oseiler2/CO2Monitor/case/Panel dimensions.PNG

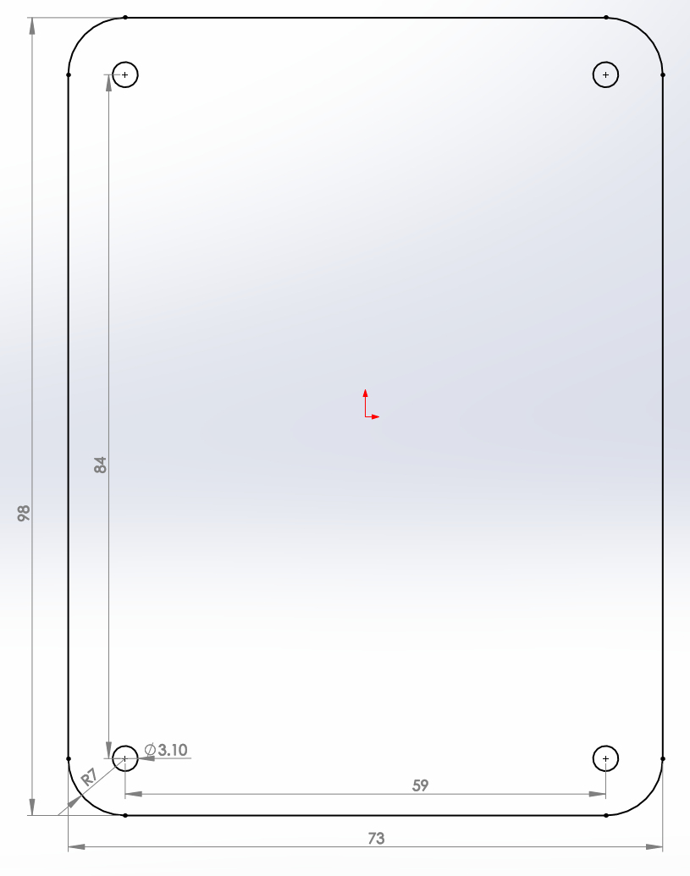
case/Panel dimensions.PNG
