oseiler2/CO2Monitor/case/Case v0.4_15mm_cable.STL

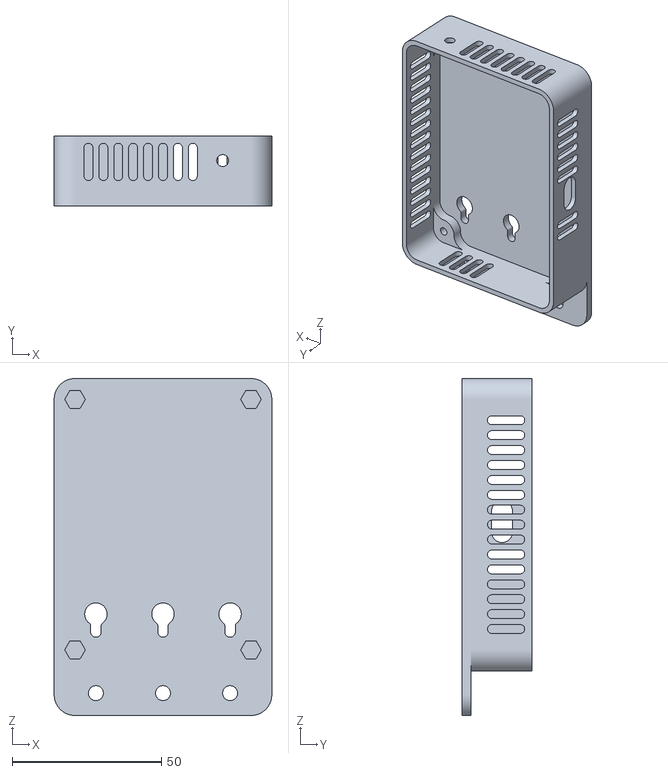
[picture p13: CAD file, 2022-06-09]
case/Case v0.4_15mm_cable.STL
73.0 x 23.6 x 113.0
