oseiler2/CO2Monitor/pcb/CO2 Monitor V0.5 SMD/3dmodels/SCD30--3DModel-STEP-56544.STEP

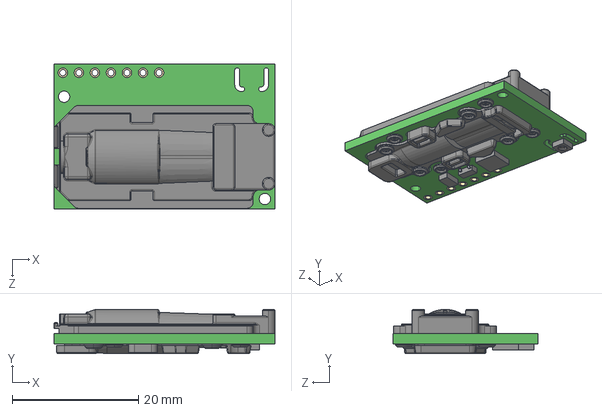
[picture p14: CAD file, 2022-06-16]
pcb/CO2 Monitor V0.5 SMD/3dmodels/SCD30--3DModel-STEP-56544.STEP
35.0 x 7.00 x 23.0 mm
