oseiler2/CO2Monitor/case/Case v0.4_15mmSPS30_USB.STL

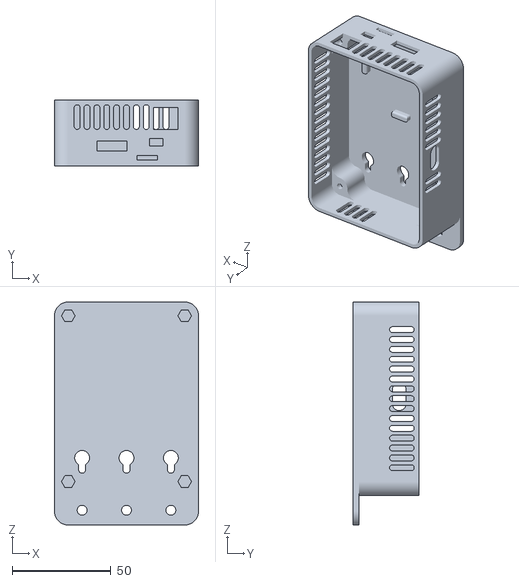
[picture p16: CAD file, 2022-06-09]
case/Case v0.4_15mmSPS30_USB.STL
73.0 x 33.6 x 113.0
