oseiler2/CO2Monitor/pcb/CO2 Monitor V0.5 through-hole/3dmodels/USB 2.0 Type B Connector Right Angle (Würth 61400416121).stp

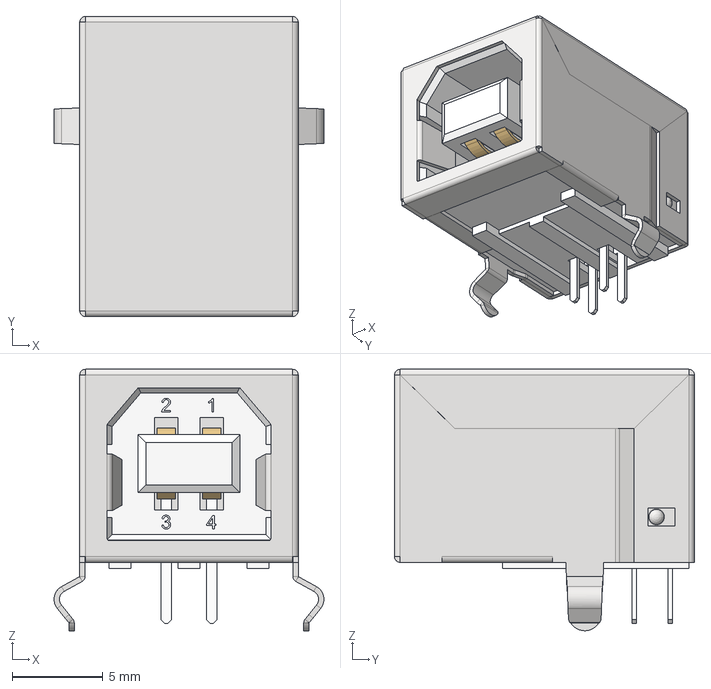
[picture p17: CAD file, 2022-06-16]
pcb/CO2 Monitor V0.5 through-hole/3dmodels/USB 2.0 Type B Connector Right Angle (Würth 61400416121).stp
14.8 x 16.5 x 14.4 mm
