oseiler2/CO2Monitor/pcb/CO2 Monitor V0.5 SMD/3dmodels/USB-B-SMD 1-1734346-1.step

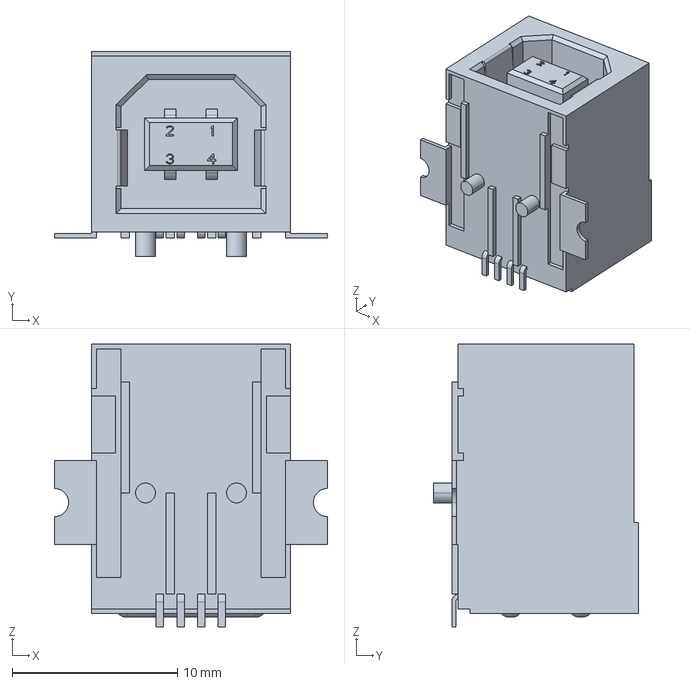
[picture p19: CAD file, 2022-06-16]
pcb/CO2 Monitor V0.5 SMD/3dmodels/USB-B-SMD 1-1734346-1.step
16.5 x 12.4 x 17.1 mm
