oseiler2/CO2Monitor/pcb/CO2 Monitor V0.5 SMD/3dmodels/BME680.step

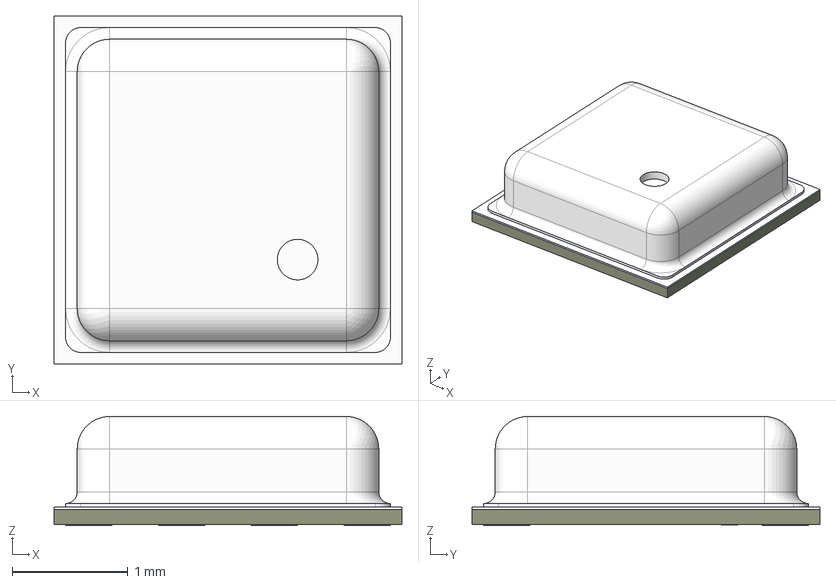
[picture p21: CAD file, 2022-06-16]
pcb/CO2 Monitor V0.5 SMD/3dmodels/BME680.step
3.00 x 3.00 x 0.94 mm
pads
pcb
lid
