oseiler2/CO2Monitor/pcb/CO2 Monitor V0.5 SMD/3dmodels/SCD40-D-R2--3DModel-STEP-369182.STEP

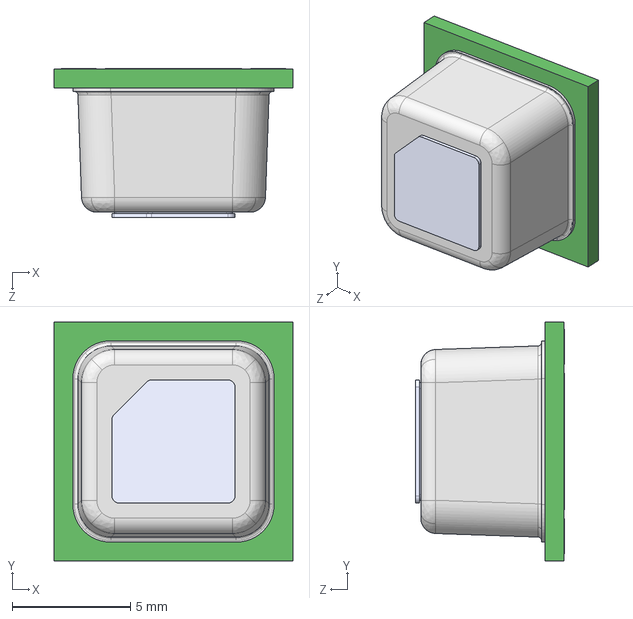
[picture p22: CAD file, 2022-06-16]
pcb/CO2 Monitor V0.5 SMD/3dmodels/SCD40-D-R2--3DModel-STEP-369182.STEP
10.1 x 10.1 x 6.31 mm
