oseiler2/CO2Monitor/pcb/CO2 Monitor V0.5 SMD/3dmodels/B5B-ZR_LF__SN_.step

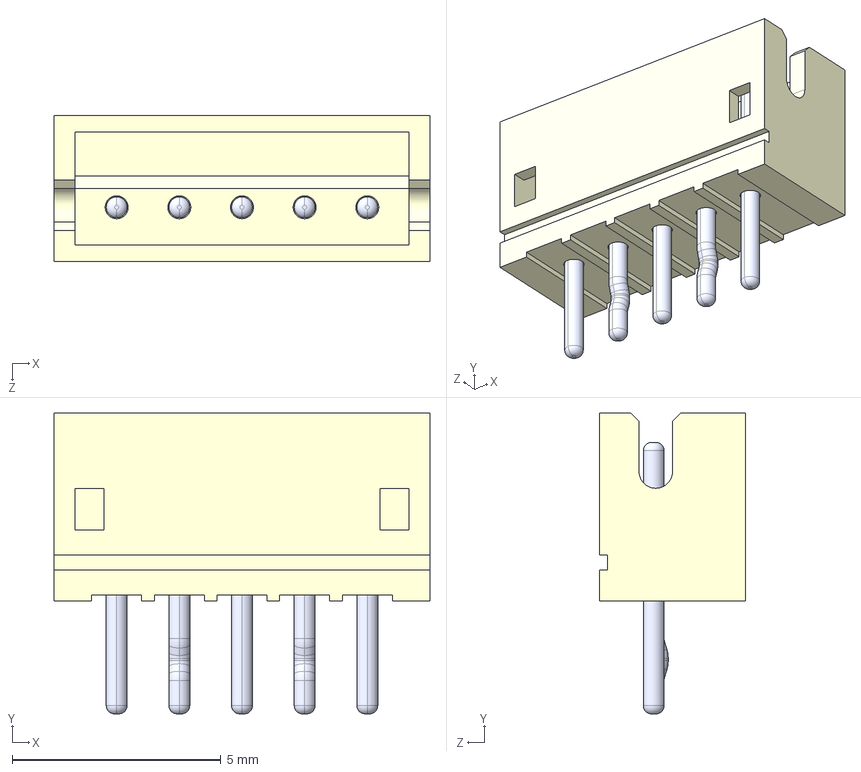
[picture p23: CAD file, 2022-06-16]
pcb/CO2 Monitor V0.5 SMD/3dmodels/B5B-ZR_LF__SN_.step
9.00 x 7.20 x 3.50 mm
