oseiler2/CO2Monitor/pcb/CO2 Monitor V0.5 through-hole/step-by-step.md

# CO2 monitor through-hole step by step assembly guide

This guide will take you through all necessary steps to assemble the through-hole version of the CO2 monitor if you ware building your own from a kit or parts that you have sourced yourself.

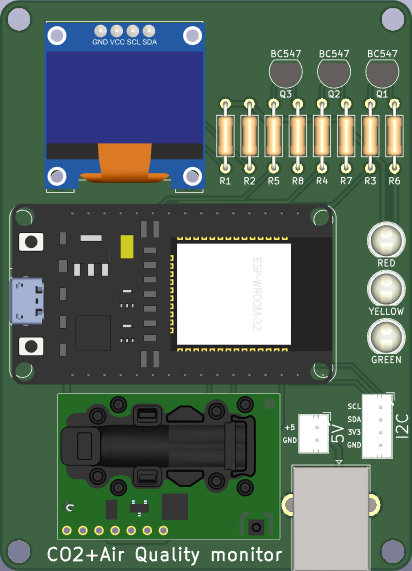
[picture p24: pcb/CO2 Monitor V0.5 through-hole/CO2Monitor-TH-V0.5.render.png]


## Preparations



Before you start make sure you have all [required parts](./bom.md) and tools ready. You'll need:

- soldering iron
- solder
- good ventilation and ideally a solder fume extractor
- side cutters
- safety glasses
- USB power
- micro USB cable
- 2mm hex (Allen) key
- (optional) multimeter

## PCB assembly

1. Start with soldering the resistors to the PCB. If you are unsure about the resistor values and don't have a multimeter handy use a [resistor colour code decoder](https://www.digikey.co.nz/en/resources/conversion-calculators/conversion-calculator-resistor-color-code) to confirm the correct value. Bend the resistors at ~10mm and put them through the PCB before soldering them in place. Cut the wires close to the PCB once soldered in place.

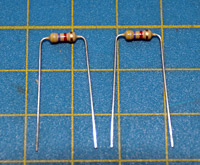
[picture p25: pcb/CO2 Monitor V0.5 through-hole/01-resistors.jpg]
   

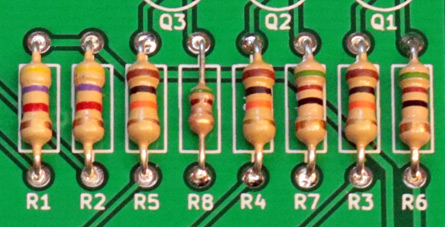
[picture p26: pcb/CO2 Monitor V0.5 through-hole/02-resistors.jpg]
   

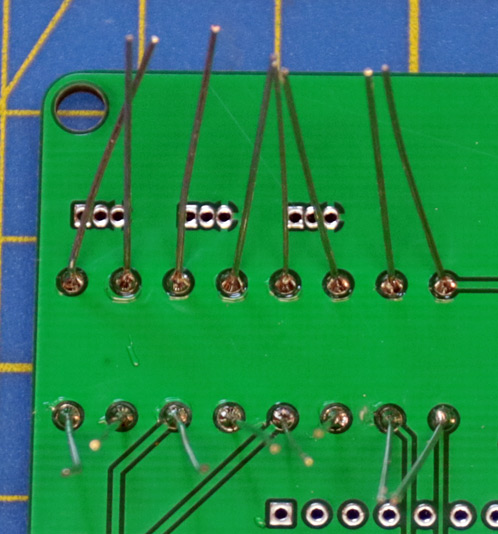
[picture p27: pcb/CO2 Monitor V0.5 through-hole/03-resistors.jpg]
   

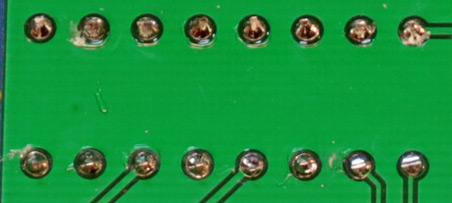
[picture p28: pcb/CO2 Monitor V0.5 through-hole/04-resistors.jpg]
   

2. Place the 3 BC547 transistors in place making sure the flat side of the package aligns with the shape of the silkscreen. You might have to bend the wires a little to make them fit. You don't need to push them all the way to the bottom, but make sure that the wires don't touch each other.

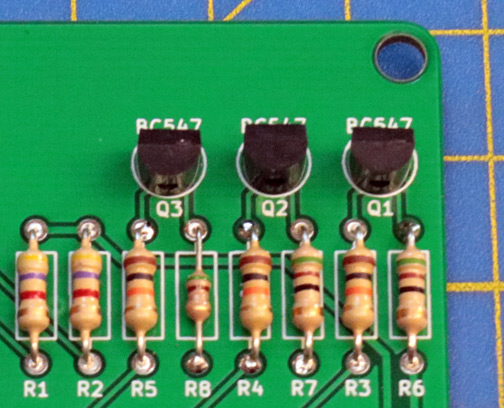
[picture p29: pcb/CO2 Monitor V0.5 through-hole/05-transistors.jpg]
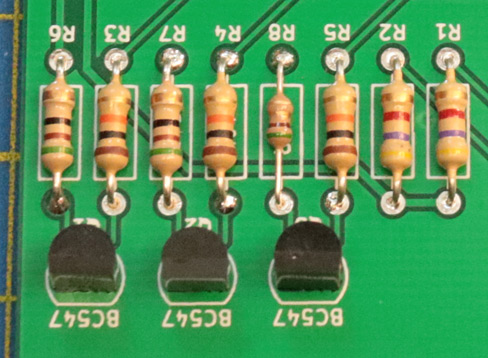
[picture p30: pcb/CO2 Monitor V0.5 through-hole/06-transistors.jpg]
    

3. The 3 LEDs must be installed in the correct orientation with the anode (+ side) facing the top of the PCB. The lead on the anode is a little longer. You can also check the correct orientation with a multimeter

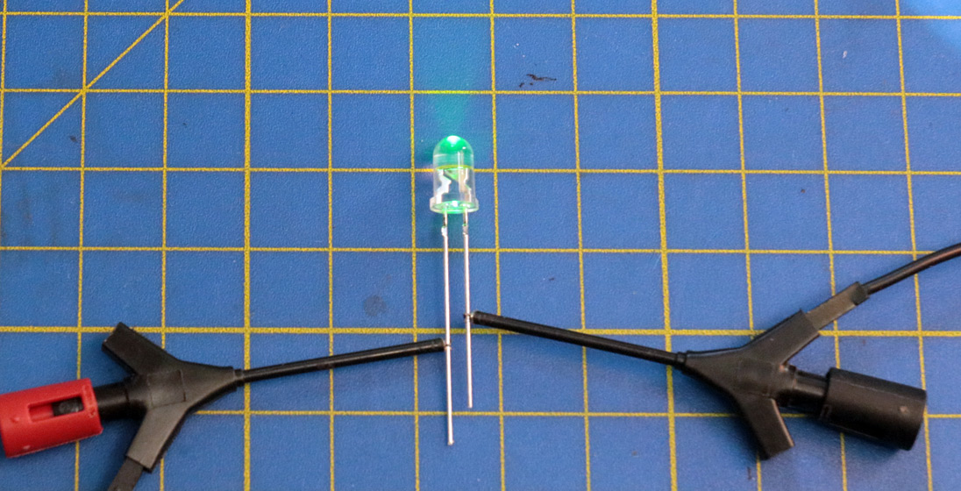
[picture p31: pcb/CO2 Monitor V0.5 through-hole/07-leds.jpg]
   

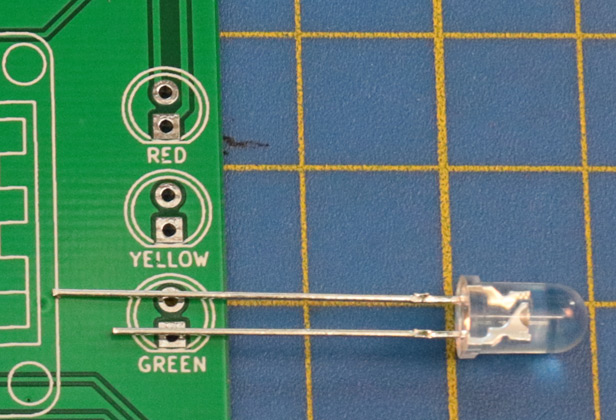
[picture p32: pcb/CO2 Monitor V0.5 through-hole/08-leds.jpg]
   

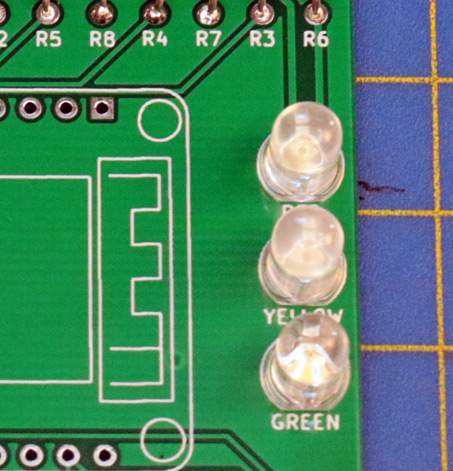
[picture p33: pcb/CO2 Monitor V0.5 through-hole/09-leds.jpg]
   

4. The ESP32 micro controller comes next. Make sure to install it in the right direction with the USB port facing left. It can be a little difficult to push in if the pins don't perfectly align. In that case start at one side and slowly move from pin to pin, carefully pushing each pin into position. Start soldering at one end and check that it is fully inserted after soldering the first pin before continuing with the reamining pins. When you're done soldering the pins will need to be shortened with a wire cutter for the PCB to properly fit into the case. When clipping the pins be careful since they are thicker than resistor wires and tend to fly away. Wear safety glasses and cover then pins with a cloth/rug when clipping them.

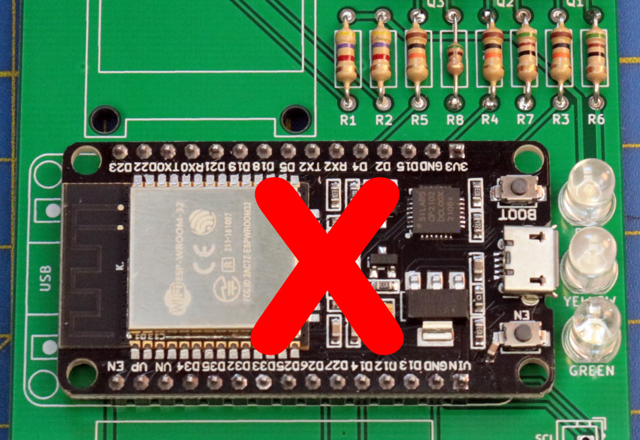
[picture p34: pcb/CO2 Monitor V0.5 through-hole/10-esp32.jpg]
   

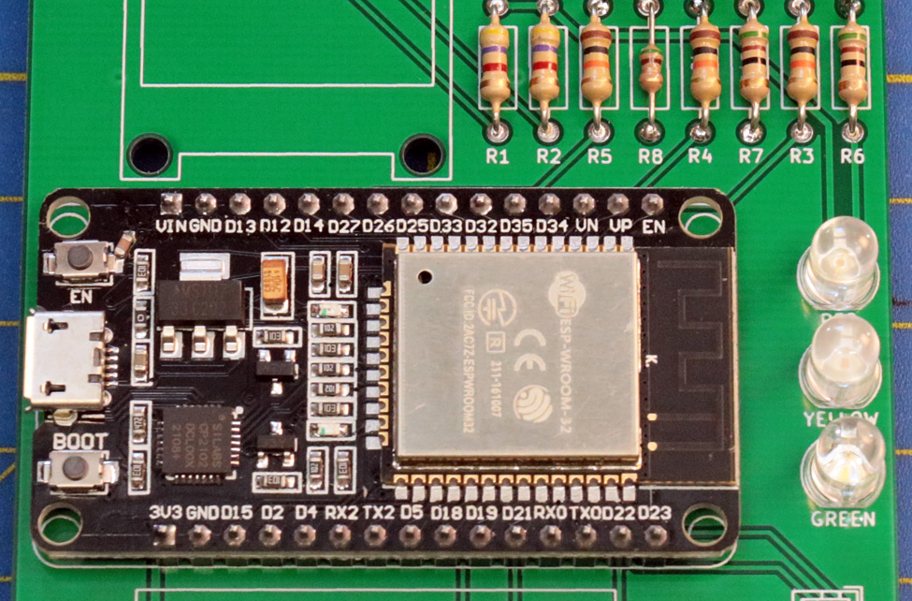
[picture p35: pcb/CO2 Monitor V0.5 through-hole/11-esp32.jpg]
   

5. Solder only one pin of the display before checking the correct alignment. It's easier to adjust while only one pin is connected. Then solder the remaining pins. Leave the protective film on the display for now.

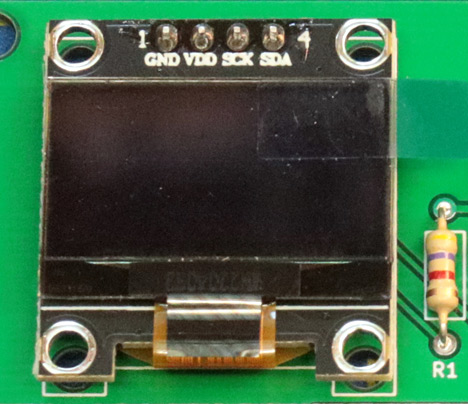
[picture p36: pcb/CO2 Monitor V0.5 through-hole/12-lcd.jpg]
   

6. If the SCD30 sensor comes without a pre-soldered pin header, solder a 7 pin header to the sensor first. If you have a prototyping bread board available use it to keep the pin header straight; otherwise carefully solder one pin only and adjust as needed before completing the remaining ones.

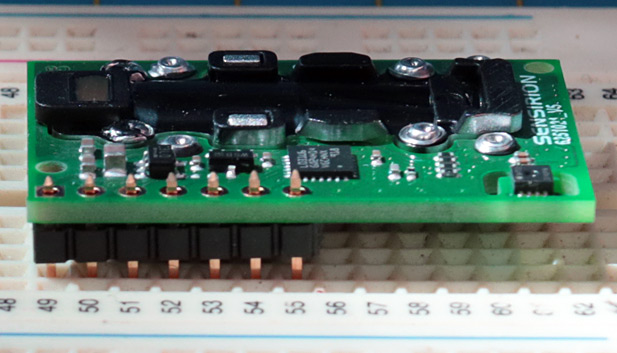
[picture p37: pcb/CO2 Monitor V0.5 through-hole/13-scd30.jpg]


Solder the SCD30 sensor to the main PCB while making sure it lies flat on the board. Don't push the pins in all the way.

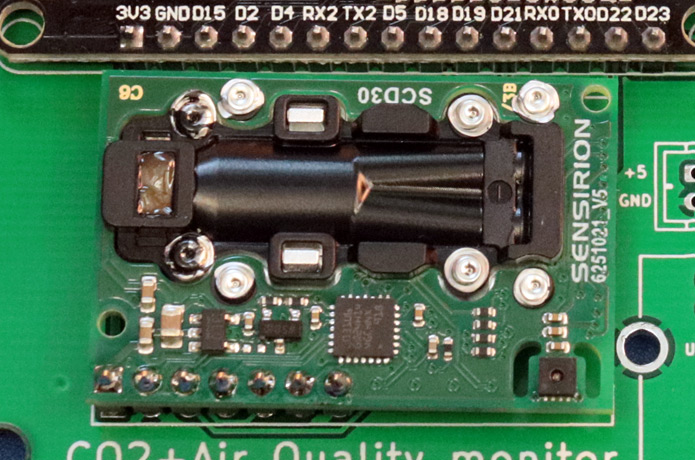
[picture p38: pcb/CO2 Monitor V0.5 through-hole/15-scd30.jpg]


7. (optional) Place and solder the JST headers for power and I2C and the USB-B power connector.

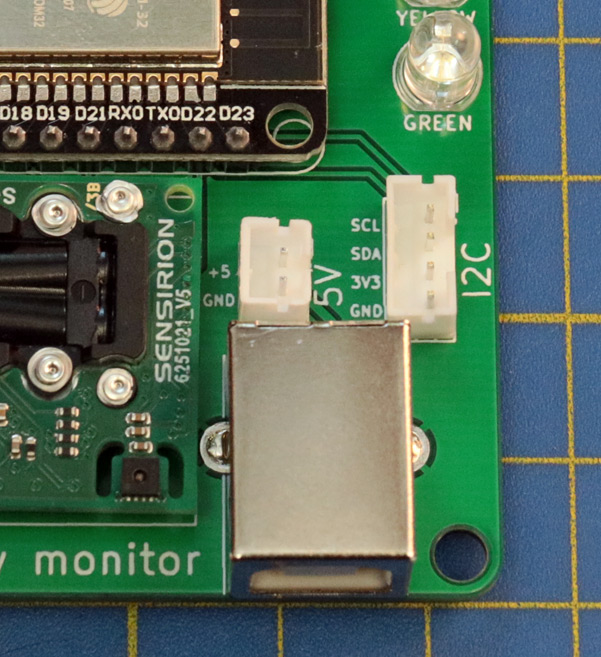
[picture p39: pcb/CO2 Monitor V0.5 through-hole/16-connectors.jpg]


8. (optional) Apply a small amount of liquid electrical tape over the 2 LEDs on the ESP32 to reduce their brightness.

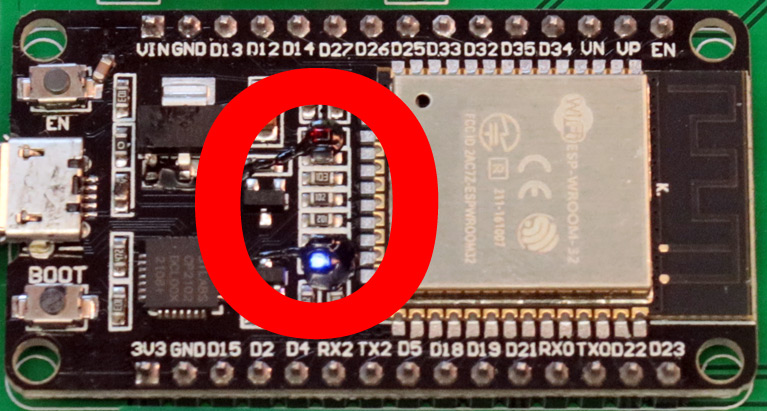
[picture p40: pcb/CO2 Monitor V0.5 through-hole/17-liquid-tape.jpg]


9. Before plugging the monitor in, have a good look at all components and make sure that all components are installed in the correct location and orientation, all solder joints are well done and not short circuited and everything looks right. Then plug a micro-USB cable into the ESP32 and flash the firmware.
   The monitor will start up and display the name of its WiFi access point in the first row on the display. After a short while it will also show a CO2 reading. Don't worry that the LEDs don't turn on quite yet as they'll need to be enabled in the configuration first.

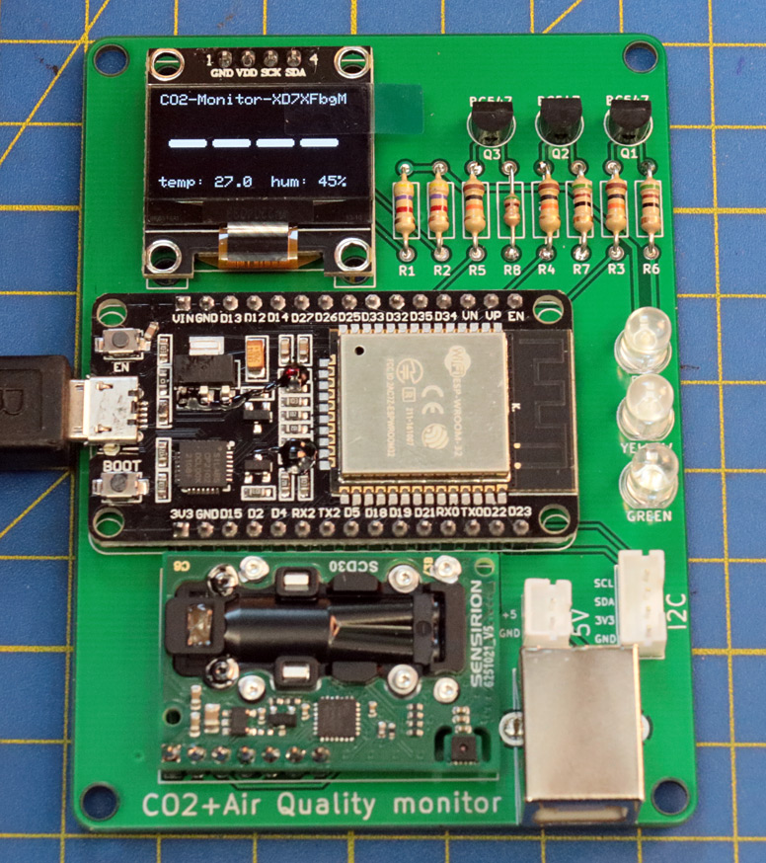
[picture p41: pcb/CO2 Monitor V0.5 through-hole/18-flash.jpg]


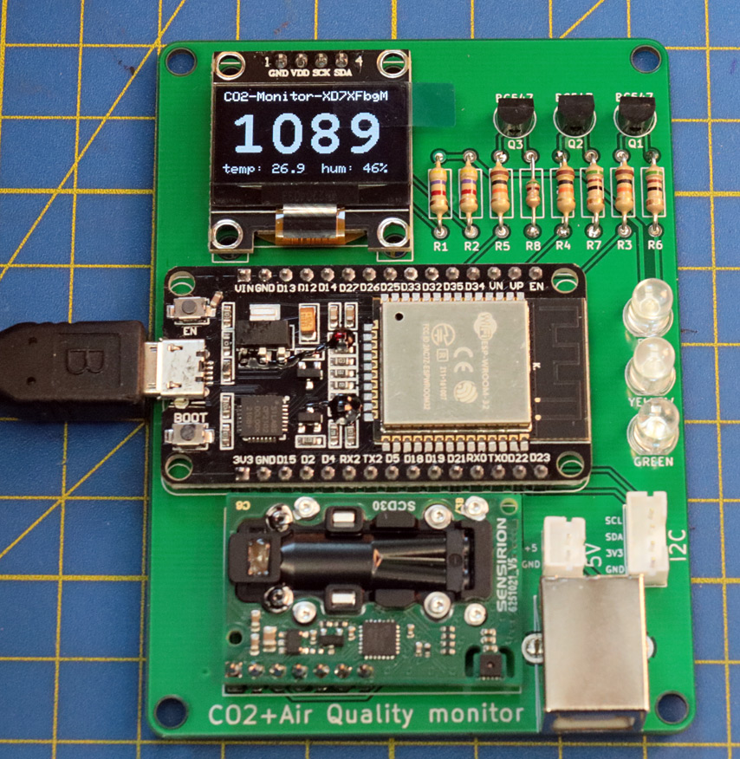
[picture p42: pcb/CO2 Monitor V0.5 through-hole/19-flash.jpg]


10. Connect to the monitor's Wifi access point and configure the Wifi and enable the LEDs by setting the following in the configuration:

```
  "greenLed": 27,
  "yellowLed": 26,
  "redLed": 25,
```

You'll then see the LEDs light up according to the CO2 reading. The electrical part of the assembly is complete.

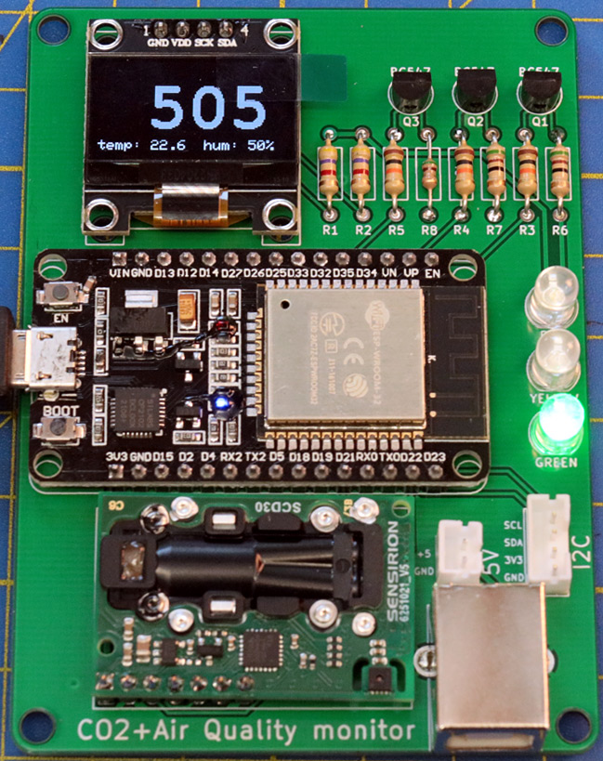
[picture p43: pcb/CO2 Monitor V0.5 through-hole/20-test.jpg]


11. There are 2 ways to install the monitor in the case. Placing it upside down on the front panel can be easier.
    Remove the protective film from the acrylic front panel and the LCD. Push the 4 screws through the front panel and place it on a flat surface with the screw heads facing down. Then push the stand offs over the screws before placing the PCB upside down over the screws.

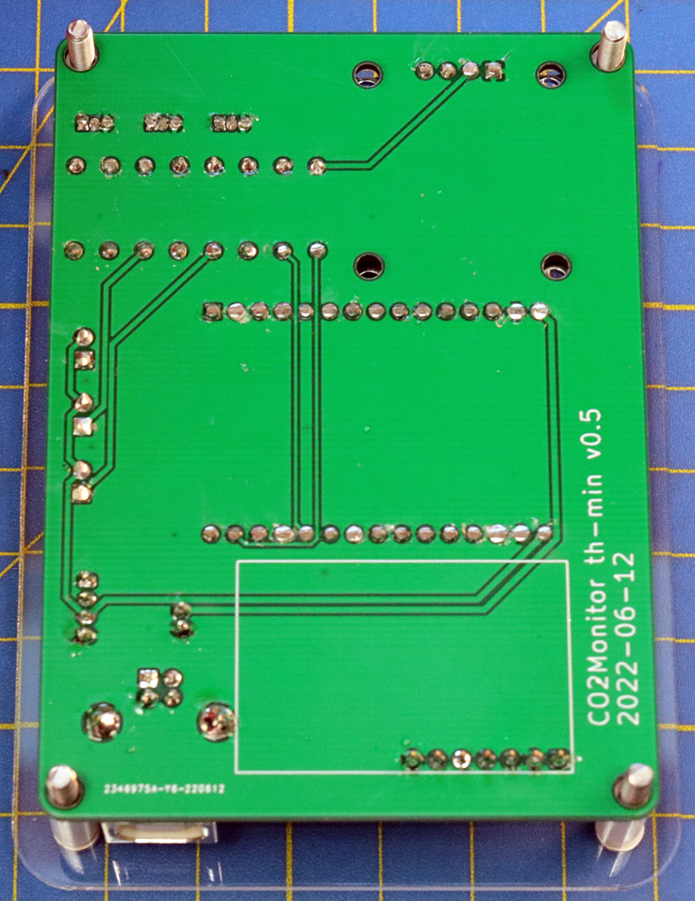
[picture p44: pcb/CO2 Monitor V0.5 through-hole/21-assembly.jpg]


Then place the case upside down over the screws, carefully pushing the screws through the holes. Place the hex nuts, carefully lift the case sideways and secure the screws with a hex (Allen) key without overtightening them. You can use a little bit of glue, electrical tape or similar to hold the hex nuts in place and stop them from falling out.

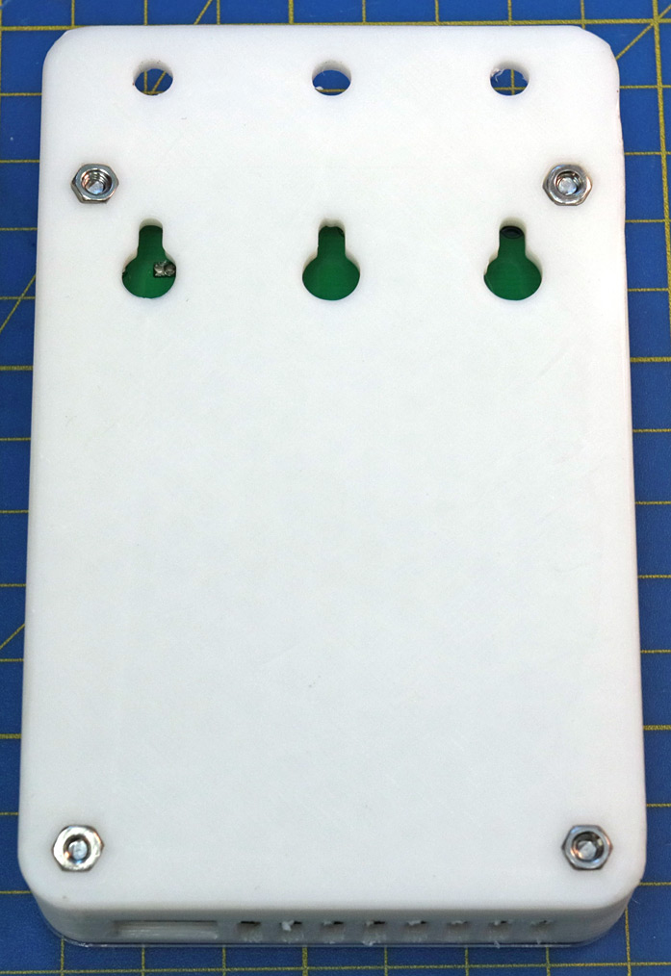
[picture p45: pcb/CO2 Monitor V0.5 through-hole/22-assembly.jpg]


12. Alternatively start with the case in the correct orientation and place the PCB into the case. You can insert the hex nuts first and secure them in place, or add them later, depending on what works best for you. Remove the protective film from the display. Slide the stand offs over a screw-driver or hex (Allen) key into position and carefully let them rest on the PCB before placing the front panel on top. The stand offs don't need to be perfectly aligned and the front panel can be moved sideways to some degree while inserting the screws through the panel and stand offs into the bottom holes of the case. Secure the screws with a hex (Allen) key without overtightening them.

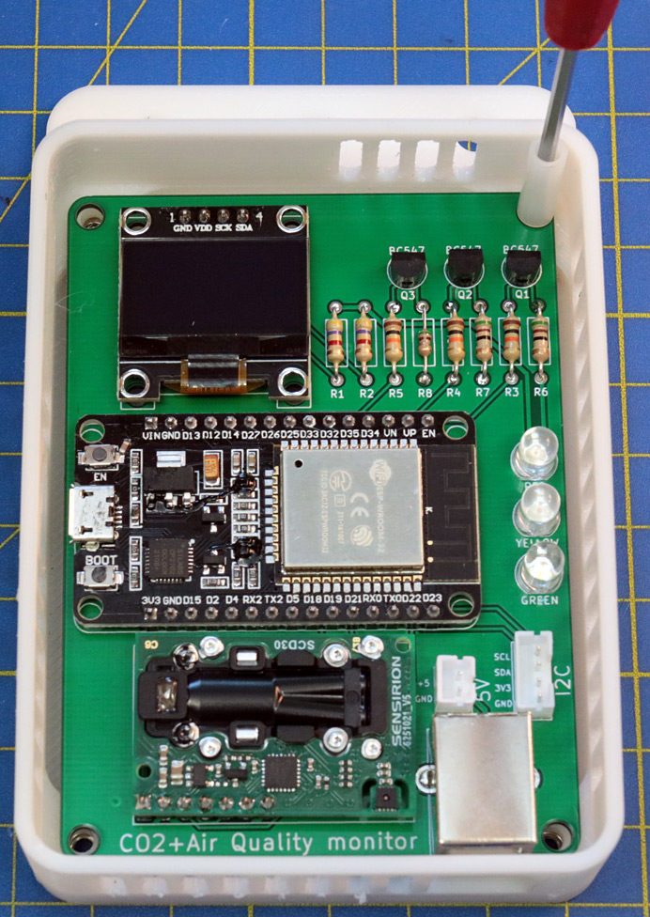
[picture p46: pcb/CO2 Monitor V0.5 through-hole/23-assembly.jpg]


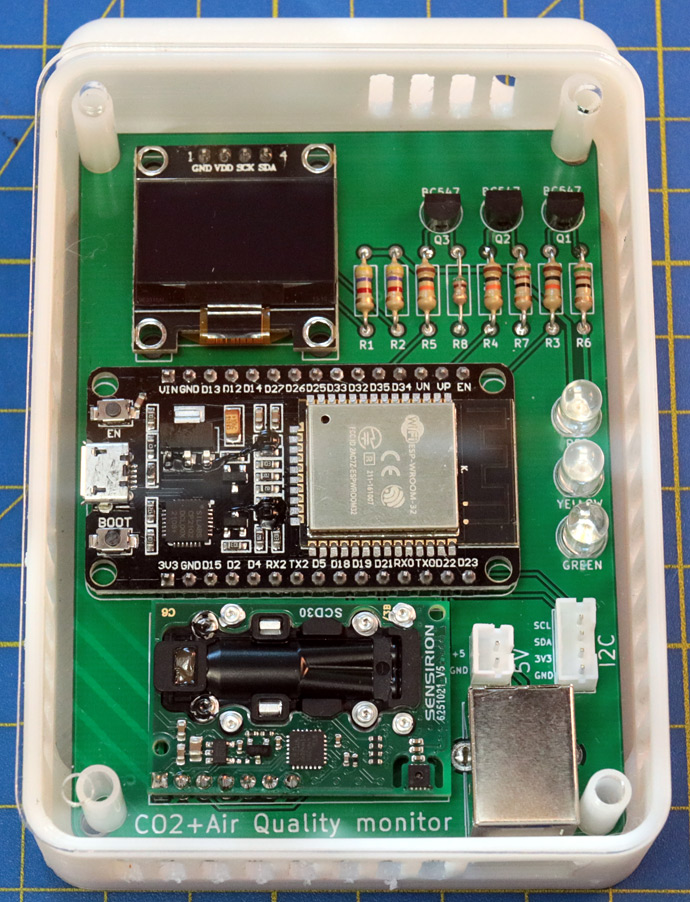
[picture p47: pcb/CO2 Monitor V0.5 through-hole/24-assembly.jpg]


13. Finally stick the small diffusor film over the LEDs to make them better visible and less blinding.

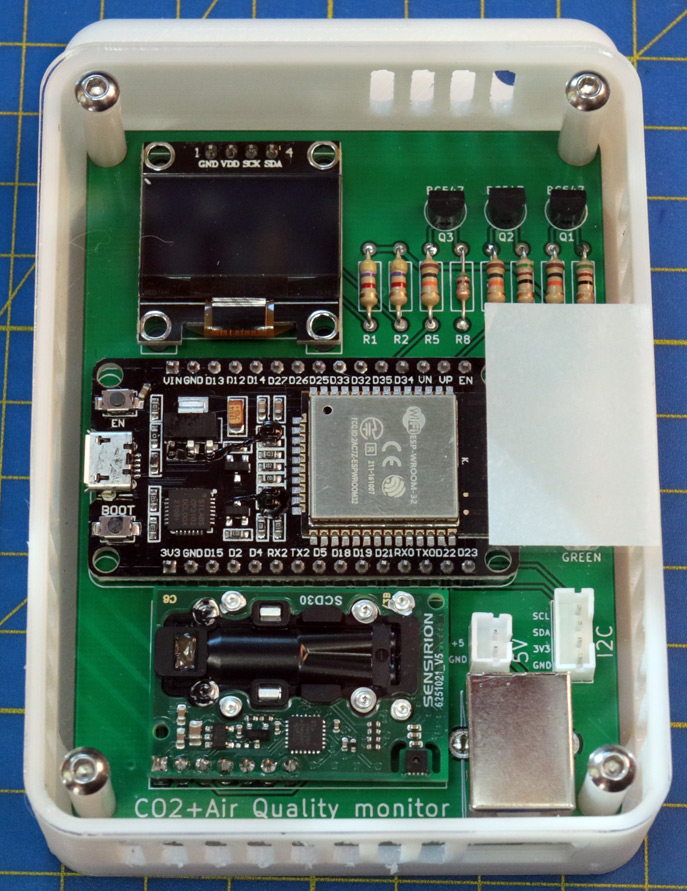
[picture p48: pcb/CO2 Monitor V0.5 through-hole/25-diffusor.jpg]


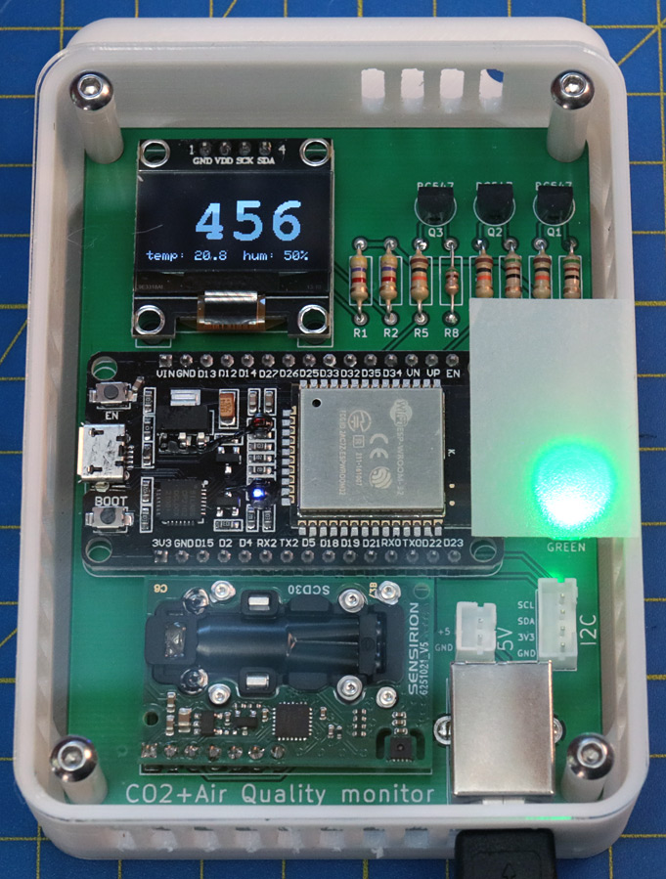
[picture p49: pcb/CO2 Monitor V0.5 through-hole/26-diffusor.jpg]
