oseiler2/CO2Monitor/pcb/CO2 Monitor V0.5 SMD/CO2Monitor SMD V0.5.kicad_pcb

## KiCad design pcb/CO2 Monitor V0.5 SMD/CO2Monitor SMD V0.5.kicad_pcb (2022-06-16)

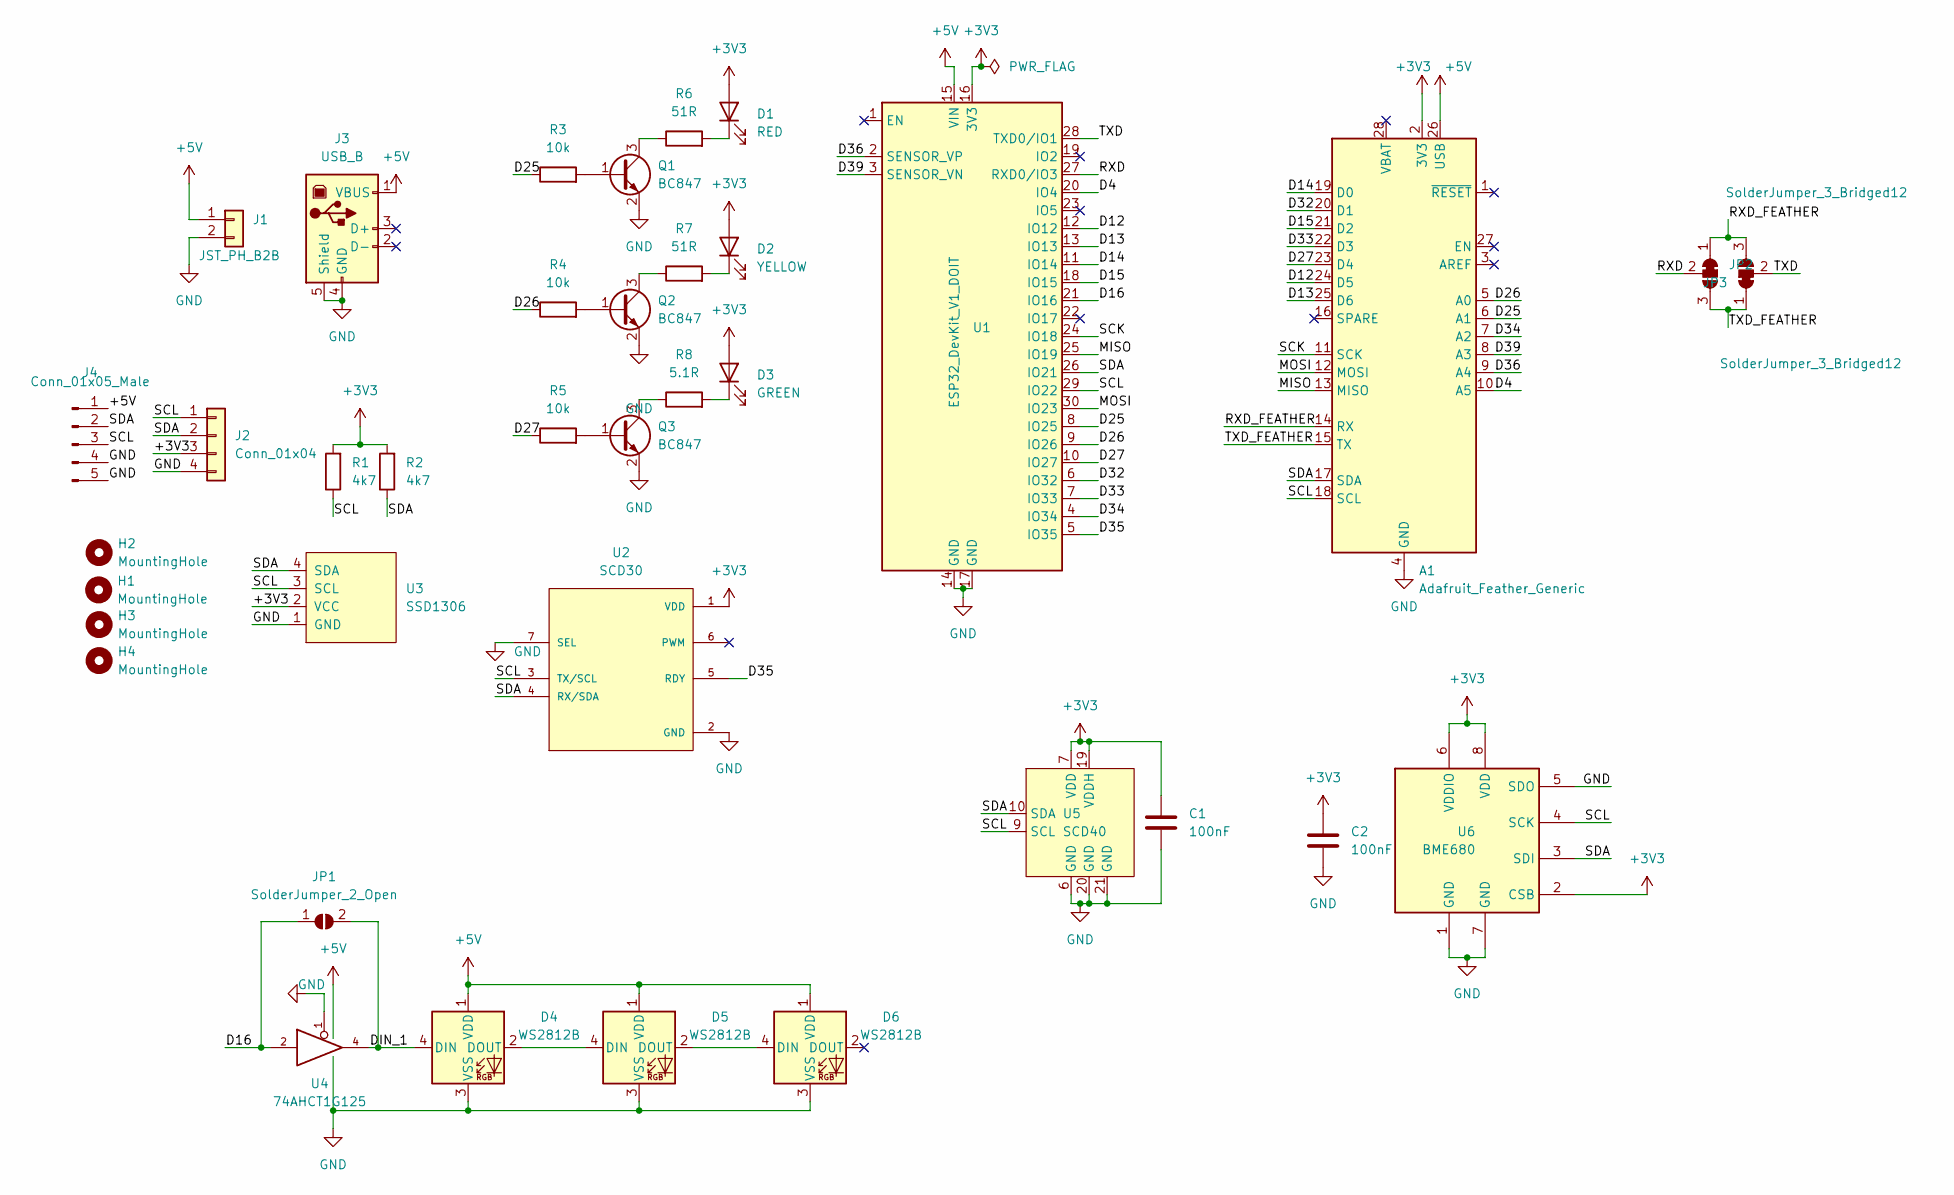
[picture p50: schematic CO2Monitor SMD V0.5.kicad_sch]

Parts:
A1: Adafruit_Feather_Generic; Adafruit_Feather
C1, C2: 100nF; C_0805_2012Metric
D1: RED; LED_D5.0mm_Clear
D2: YELLOW; LED_D5.0mm_Clear
D3: GREEN; LED_D5.0mm_Clear
D4, D5, D6: WS2812B; LED_WS2812B_PLCC4_5.0x5.0mm_P3.2mm
H1, H2, H3, H4: MountingHole; MountingHole_3.5mm
J1: JST_PH_B2B; JST_PH_B2B-PH-K_1x02_P2.00mm_Vertical
J2: Conn_01x04; JST_PH_B4B-PH-K_1x04_P2.00mm_Vertical
J3: USB_B; TE_1-1734346-1
J4: Conn_01x05_Male
JP1: SolderJumper_2_Open; SolderJumper-2_P1.3mm_Open_TrianglePad1.0x1.5mm
JP2, JP3: SolderJumper_3_Bridged12; SolderJumper-3_P1.3mm_Bridged12_RoundedPad1.0x1.5mm
Q1, Q2, Q3: BC847; SOT-23
R1, R2: 4k7; R_0805_2012Metric
R3, R4, R5: 10k; R_0805_2012Metric
R6, R7: 51R; R_0805_2012Metric
R8: 5.1R; R_0805_2012Metric
U1: ESP32_DevKit_V1_DOIT; esp32_devkit_v1_doit
U2: SCD30; PARTREV D1
U3: SSD1306; OLED_128x64_0.96_small_no_holes
U4: 74AHCT1G125; SOT-23-5
U5: SCD40; SCD40-D-R1
U6: BME680; Bosch_LGA-8_3x3mm_P0.8mm_ClockwisePinNumbering

Connections:
+3V3: A1.2 (3V3), C1.1, C2.1, D1.2 (A), D2.2 (A), D3.2 (A), J2.3, R1.2, R2.2, U1.16 (3V3), U2.1 (VDD), U3.2 (VCC), U5.7 (VDD), U5.19 (VDDH), U6.2 (CSB), U6.6 (VDDIO), U6.8 (VDD)
+5V: A1.26 (USB), D4.1 (VDD), D5.1 (VDD), D6.1 (VDD), J1.1, J3.1 (VBUS), J4.1, U1.15 (VIN), U4.5 (VCC)
/D4: A1.10 (A5), U1.20 (IO4)
/D12: A1.24 (D5), U1.12 (IO12)
/D13: A1.25 (D6), U1.13 (IO13)
/D14: A1.19 (D0), U1.11 (IO14)
/D15: A1.21 (D2), U1.18 (IO15)
/D16: JP1.1 (A), U1.21 (IO16), U4.2
/D25: A1.6 (A1), R3.1, U1.8 (IO25)
/D26: A1.5 (A0), R4.1, U1.9 (IO26)
/D27: A1.23 (D4), R5.1, U1.10 (IO27)
/D32: A1.20 (D1), U1.6 (IO32)
/D33: A1.22 (D3), U1.7 (IO33)
/D34: A1.7 (A2), U1.4 (IO34)
/D35: U1.5 (IO35), U2.5 (RDY)
/D36: A1.9 (A4), U1.2 (SENSOR_VP)
/D39: A1.8 (A3), U1.3 (SENSOR_VN)
/DIN_1: D4.4 (DIN), JP1.2 (B), U4.4
/MISO: A1.13 (MISO), U1.25 (IO19)
/MOSI: A1.12 (MOSI), U1.30 (IO23)
/RXD: JP2.2 (C), U1.27 (RXD0/IO3)
/RXD_FEATHER: A1.14 (RX), JP2.1 (A), JP3.3 (B)
/SCK: A1.11 (SCK), U1.24 (IO18)
/SCL: A1.18 (SCL), J2.1, J4.3, R1.1, U1.29 (IO22), U2.3 (TX/SCL), U3.3 (SCL), U5.9 (SCL), U6.4 (SCK)
/SDA: A1.17 (SDA), J2.2, J4.2, R2.1, U1.26 (IO21), U2.4 (RX/SDA), U3.4 (SDA), U5.10 (SDA), U6.3 (SDI)
/TXD: JP3.2 (C), U1.28 (TXD0/IO1)
/TXD_FEATHER: A1.15 (TX), JP2.3 (B), JP3.1 (A)
GND: A1.4 (GND), C1.2, C2.2, D4.3 (VSS), D5.3 (VSS), D6.3 (VSS), J1.2, J2.4, J3.4 (GND), J3.5 (Shield), J4.4, J4.5, Q1.2 (E), Q2.2 (E), Q3.2 (E), U1.14 (GND), U1.17 (GND), U2.2 (GND), U2.7 (SEL), U3.1 (GND), U4.1, U4.3 (GND), U5.6 (GND), U5.20 (GND), U5.21 (GND), U6.1 (GND), U6.5 (SDO), U6.7 (GND)
unnamed: D1.1 (K), R6.2
unnamed: D2.1 (K), R7.2
unnamed: D3.1 (K), R8.2
unnamed: D4.2 (DOUT), D5.4 (DIN)
unnamed: D5.2 (DOUT), D6.4 (DIN)
unnamed: Q1.1 (B), R3.2
unnamed: Q1.3 (C), R6.1
unnamed: Q2.1 (B), R4.2
unnamed: Q2.3 (C), R7.1
unnamed: Q3.1 (B), R5.2
unnamed: Q3.3 (C), R8.1

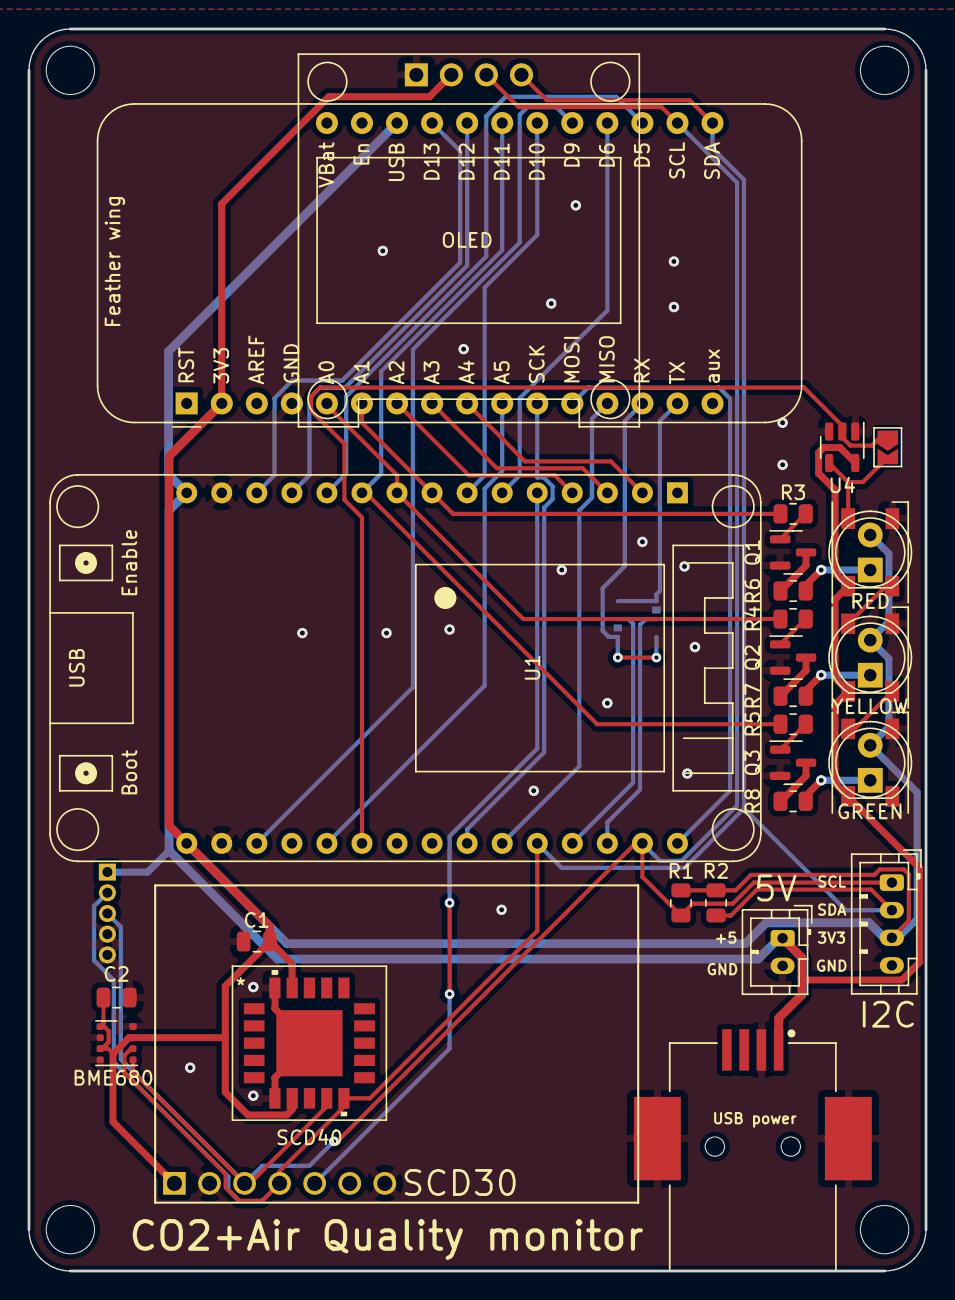
[picture p51: board CO2Monitor SMD V0.5.kicad_pcb from above]

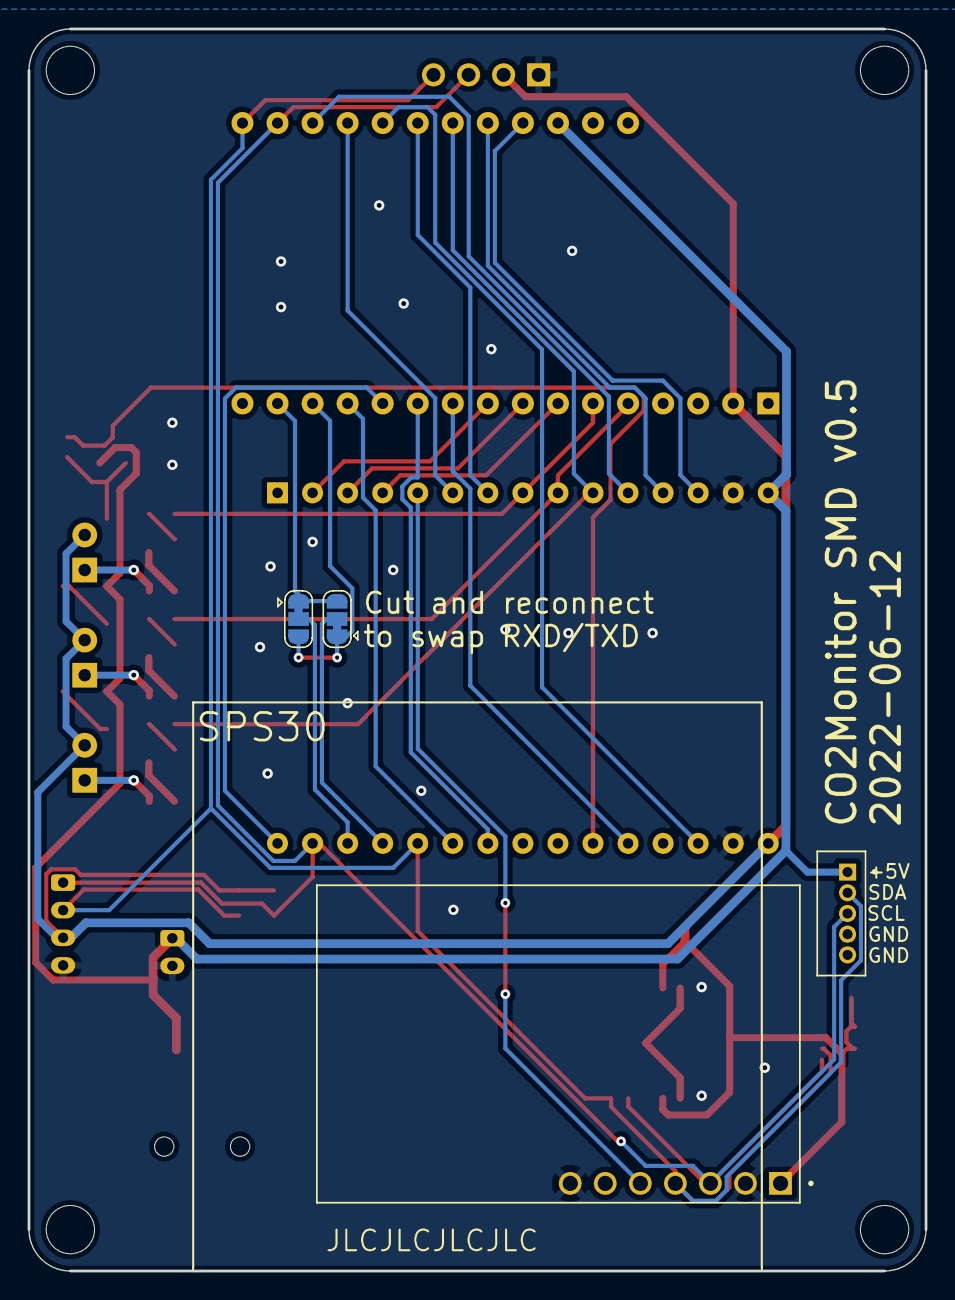
[picture p52: board CO2Monitor SMD V0.5.kicad_pcb from below]

Board: 2 copper layers, 65.0 x 90.0 mm, 37 parts (4 on the bottom side), 39 nets.
