oseiler2/CO2Monitor/pcb/CO2 Monitor V0.5 through-hole/CO2Monitor TH V0.5.kicad_pcb

## KiCad design pcb/CO2 Monitor V0.5 through-hole/CO2Monitor TH V0.5.kicad_pcb (2022-06-16)

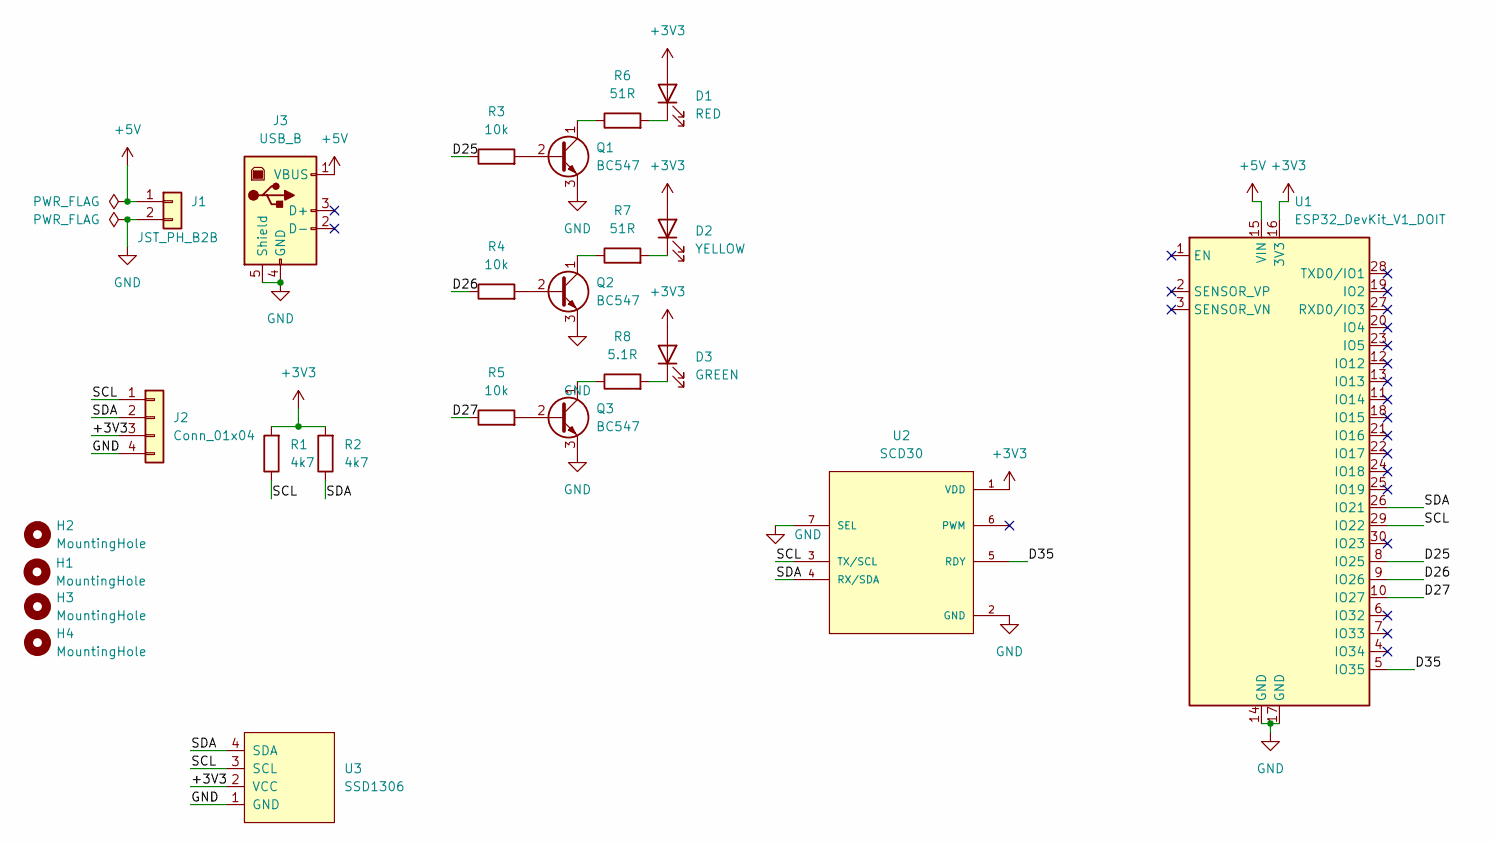
[picture p53: schematic CO2Monitor TH V0.5.kicad_sch]

Parts:
D1: RED; LED_D5.0mm_Clear
D2: YELLOW; LED_D5.0mm_Clear
D3: GREEN; LED_D5.0mm_Clear
H1, H2, H3, H4: MountingHole; MountingHole_3.5mm
J1: JST_PH_B2B; JST_PH_B2B-PH-K_1x02_P2.00mm_Vertical
J2: Conn_01x04; JST_PH_B4B-PH-K_1x04_P2.00mm_Vertical
J3: USB_B; USB_B_OST_USB-B1HSxx_Horizontal
Q1, Q2, Q3: BC547; TO-92_Inline
R1, R2: 4k7; R_Axial_DIN0207_L6.3mm_D2.5mm_P10.16mm_Horizontal
R3, R4, R5: 10k; R_Axial_DIN0207_L6.3mm_D2.5mm_P10.16mm_Horizontal
R6, R7: 51R; R_Axial_DIN0207_L6.3mm_D2.5mm_P10.16mm_Horizontal
R8: 5.1R; R_Axial_DIN0207_L6.3mm_D2.5mm_P10.16mm_Horizontal
U1: ESP32_DevKit_V1_DOIT; esp32_devkit_v1_doit
U2: SCD30; PARTREV D1
U3: SSD1306; OLED_128x64_0.96_small

Connections:
+3V3: D1.2 (A), D2.2 (A), D3.2 (A), J2.3, R1.2, R2.2, U1.16 (3V3), U2.1 (VDD), U3.2 (VCC)
+5V: J1.1, J3.1 (VBUS), U1.15 (VIN)
/D25: R3.1, U1.8 (IO25)
/D26: R4.1, U1.9 (IO26)
/D27: R5.1, U1.10 (IO27)
/D35: U1.5 (IO35), U2.5 (RDY)
/SCL: J2.1, R1.1, U1.29 (IO22), U2.3 (TX/SCL), U3.3 (SCL)
/SDA: J2.2, R2.1, U1.26 (IO21), U2.4 (RX/SDA), U3.4 (SDA)
GND: J1.2, J2.4, J3.4 (GND), J3.5 (Shield), Q1.3 (E), Q2.3 (E), Q3.3 (E), U1.14 (GND), U1.17 (GND), U2.2 (GND), U2.7 (SEL), U3.1 (GND)
unnamed: D1.1 (K), R6.2
unnamed: D2.1 (K), R7.2
unnamed: D3.1 (K), R8.2
unnamed: Q1.1 (C), R6.1
unnamed: Q1.2 (B), R3.2
unnamed: Q2.1 (C), R7.1
unnamed: Q2.2 (B), R4.2
unnamed: Q3.1 (C), R8.1
unnamed: Q3.2 (B), R5.2

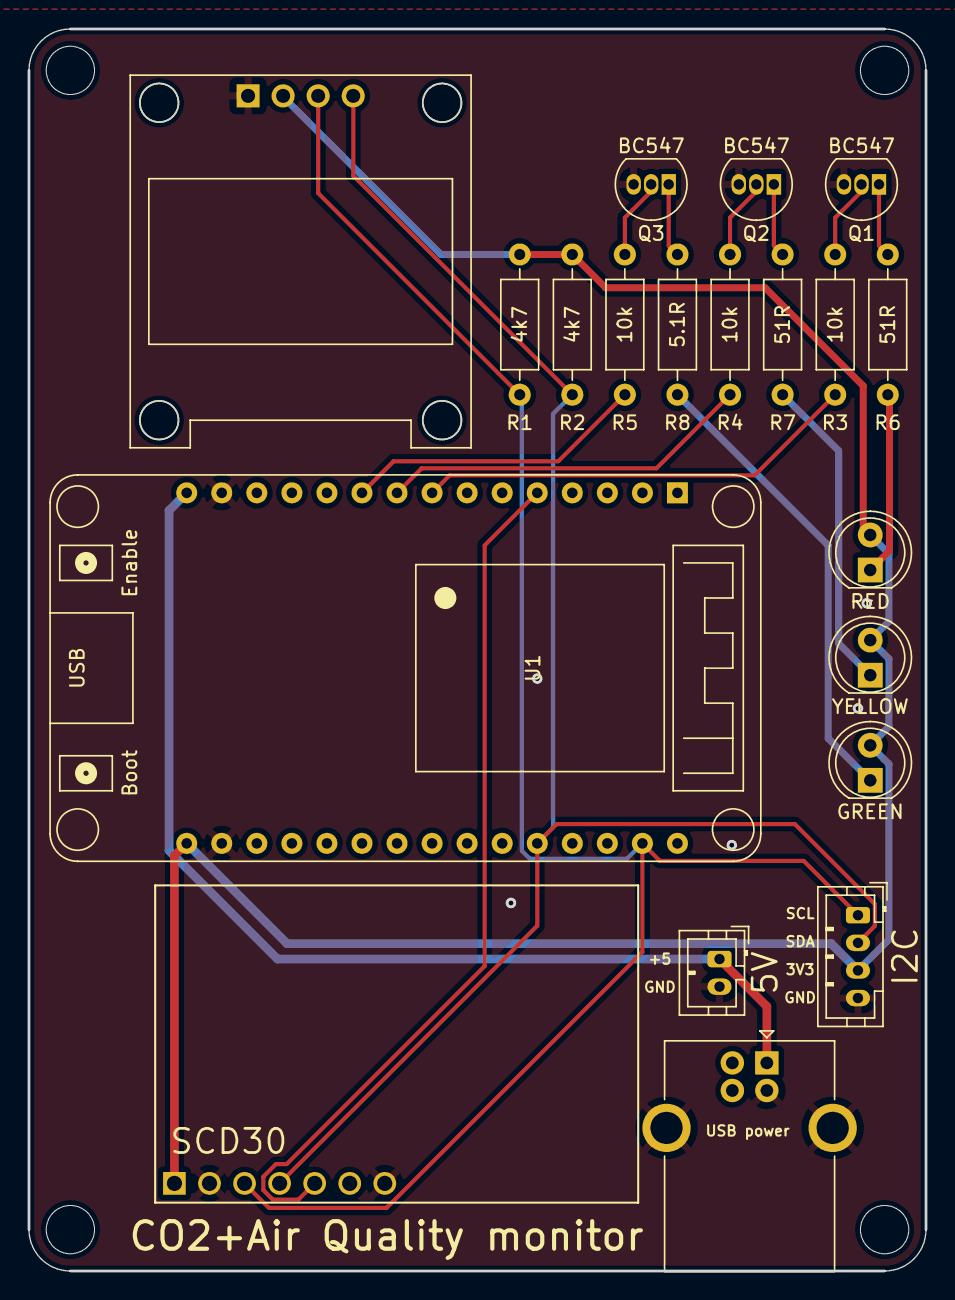
[picture p54: board CO2Monitor TH V0.5.kicad_pcb from above]

Board: 2 copper layers, 65.0 x 90.0 mm, 24 parts (1 on the bottom side), 18 nets.
