oseiler2/CO2Monitor/pcb/HUB75Adapter/HUB75.brd

## EAGLE design pcb/HUB75Adapter/HUB75.brd (2022-01-15)

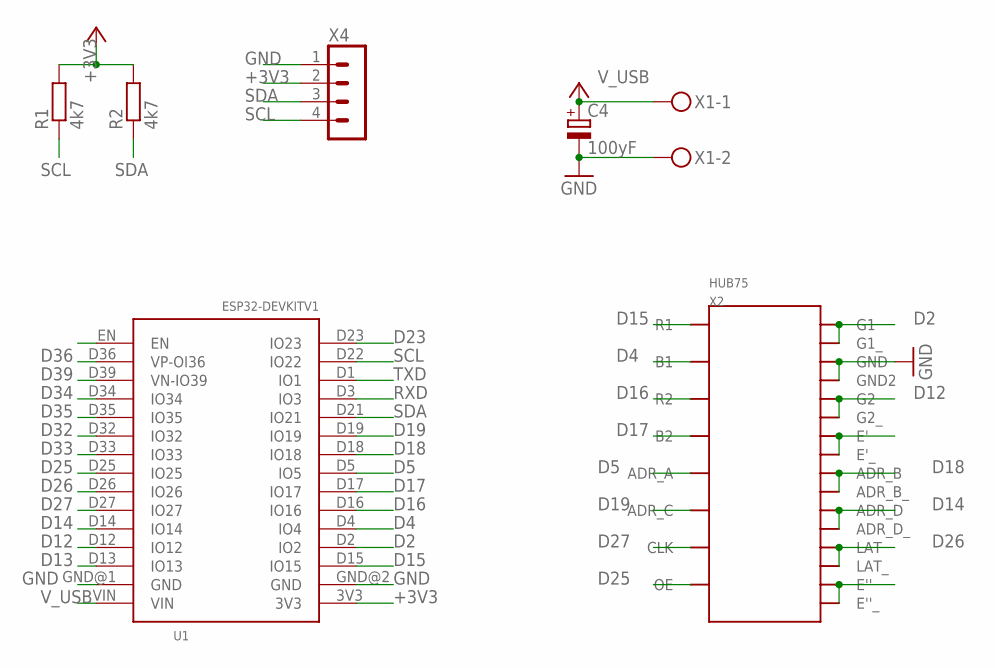
[picture p55: schematic HUB75.sch]

Parts:
C4: 100yF; E5-6
R1, R2: 4k7; R0805
U1: ESP32DEVKITV1; ESP32-DEVKITV1
X1: MKDSN1,5/2-5,08
X2: HUB75; 3X8
X4: B4B-PH-K

Connections:
+3V3: R1.2, R2.2, U1.3V3, X4.2
D2: U1.D2 (IO2), X2.2 (G1), X2.2B (G1_)
D4: U1.D4 (IO4), X2.3 (B1)
D5: U1.D5 (IO5), X2.9 (ADR_A)
D12: U1.D12 (IO12), X2.6 (G2), X2.6B (G2_)
D13: U1.D13 (IO13)
D14: U1.D14 (IO14), X2.12 (ADR_D), X2.12B (ADR_D_)
D15: U1.D15 (IO15), X2.1 (R1)
D16: U1.D16 (IO16), X2.5 (R2)
D17: U1.D17 (IO17), X2.7 (B2)
D18: U1.D18 (IO18), X2.10 (ADR_B), X2.10B (ADR_B_)
D19: U1.D19 (IO19), X2.11 (ADR_C)
D23: U1.D23 (IO23)
D25: U1.D25 (IO25), X2.15 (OE)
D26: U1.D26 (IO26), X2.14 (LAT), X2.14B (LAT_)
D27: U1.D27 (IO27), X2.13 (CLK)
D32: U1.D32 (IO32)
D33: U1.D33 (IO33)
D34: U1.D34 (IO34)
D35: U1.D35 (IO35)
D36: U1.D36 (VP-OI36)
D39: U1.D39 (VN-IO39)
GND: C4.-, U1.GND@1 (GND), U1.GND@2 (GND), X1.2, X2.4 (GND), X2.4B (GND2), X4.1
unnamed: X2.8 (E'), X2.8B (E'_)
unnamed: X2.16 (E''), X2.16B (E''_)
RXD: U1.D3 (IO3)
SCL: R1.1, U1.D22 (IO22), X4.4
SDA: R2.1, U1.D21 (IO21), X4.3
TXD: U1.D1 (IO1)
V_USB: C4.+, U1.VIN, X1.1

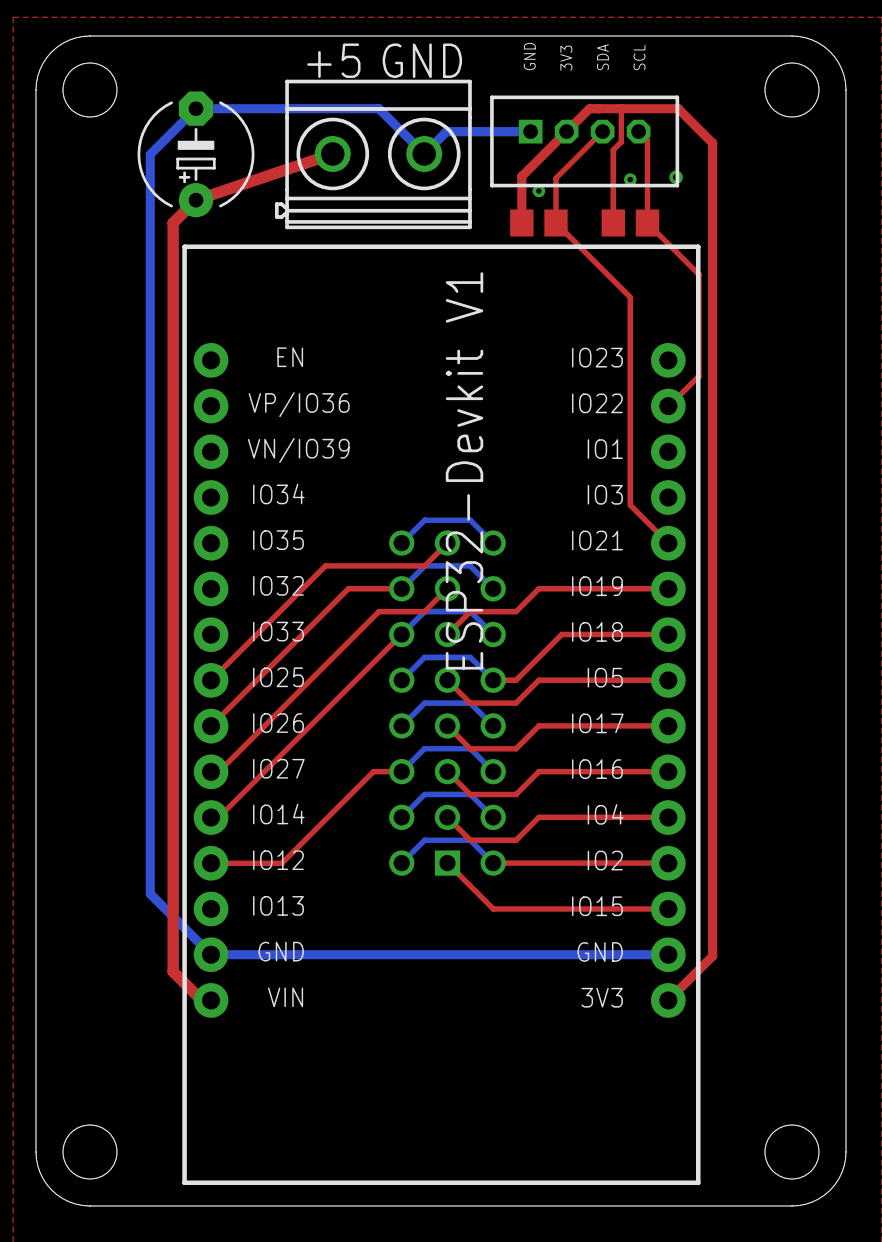
[picture p56: board HUB75.brd from above]

Board: 2 copper layers, 45.0 x 65.0 mm, 7 parts (1 on the bottom side), 20 nets.
