oseiler2/CO2Monitor/pcb/SCD40Breakout/SCD40Breakout.brd

## EAGLE design pcb/SCD40Breakout/SCD40Breakout.brd (2022-01-15)

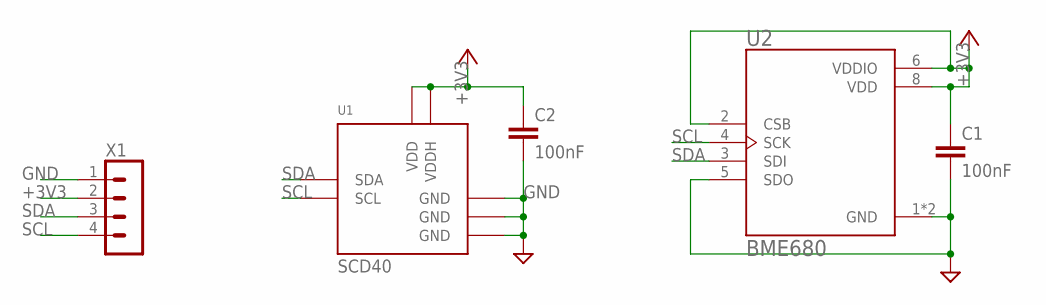
[picture p57: schematic SCD40Breakout.sch]

Parts:
C1, C2: 100nF; C0805
U1: SCD40
U2: BME680; PSON80P300X300X100-8N
X1: B4B-PH-K

Connections:
+3V3: C1.1, C2.1, U1.P$7 (VDD), U1.P$19 (VDDH), U2.2 (CSB), U2.6 (VDDIO), U2.8 (VDD), X1.2
GND: C1.2, C2.2, U1.P$6 (GND), U1.P$20 (GND), U1.P$21 (GND), U2.1 (GND), U2.5 (SDO), U2.7 (GND), X1.1
SCL: U1.P$9 (SCL), U2.4 (SCK), X1.4
SDA: U1.P$10 (SDA), U2.3 (SDI), X1.3

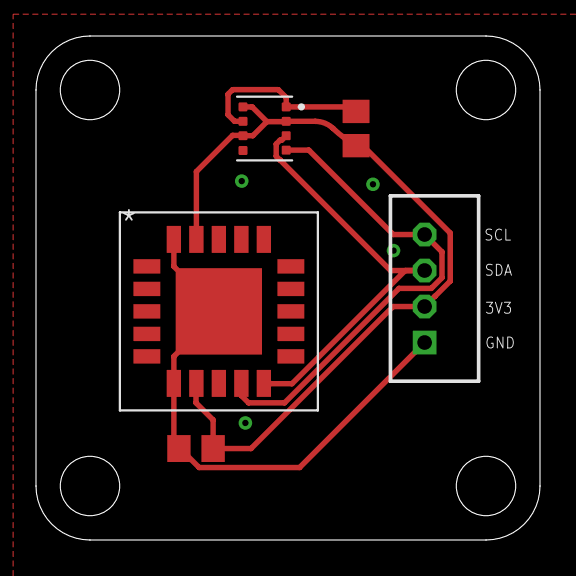
[picture p58: board SCD40Breakout.brd from above]

Board: 2 copper layers, 28.0 x 28.0 mm, 5 parts (0 on the bottom side), 4 nets.
