oseiler2/CO2Monitor/include/config.h

#ifndef _CONFIG_H
#define _CONFIG_H

#include <logging.h>
#include <sdkconfig.h>

#define OTA_URL               "https://otahost/co2monitor/firmware.json"
#define OTA_APP               "co2monitor"
//#define OTA_POLL

#if CONFIG_IDF_TARGET_ESP32

#define LED_PIN                2
#define BTN_1                  0
#define SDA_PIN              SDA
#define SCL_PIN              SCL
#define SCD30_RDY_PIN         35

#elif CONFIG_IDF_TARGET_ESP32S3

#define LED_PIN                2
#define BTN_1                  0
#define SDA_PIN               14
#define SCL_PIN               21
#define SCD30_RDY_PIN         -1

#endif

#define I2C_CLK 100000UL
#define SCD30_I2C_CLK 50000UL   // SCD30 recommendation of 50kHz

static const char* CONFIG_FILENAME = "/config.json";
static const char* MQTT_ROOT_CA_FILENAME = "/mqtt_root_ca.pem";
static const char* MQTT_CLIENT_CERT_FILENAME = "/mqtt_client_cert.pem";
static const char* MQTT_CLIENT_KEY_FILENAME = "/mqtt_client_key.pem";
static const char* TEMP_MQTT_ROOT_CA_FILENAME = "/temp_mqtt_root_ca.pem";
static const char* ROOT_CA_FILENAME = "/root_ca.pem";

#define MQTT_QUEUE_LENGTH      25

#define PWM_CHANNEL_LEDS        0

// ----------------------------  Config struct ------------------------------------- 
#define CONFIG_SIZE 1280

#define MQTT_USERNAME_LEN 20
#define MQTT_PASSWORD_LEN 20
#define MQTT_HOSTNAME_LEN 30
#define MQTT_TOPIC_LEN 30
#define SSID_LEN 32
#define WIFI_PASSWORD_LEN 64

struct Config {
  uint16_t deviceId;
  char mqttTopic[MQTT_TOPIC_LEN + 1];
  char mqttUsername[MQTT_USERNAME_LEN + 1];
  char mqttPassword[MQTT_PASSWORD_LEN + 1];
  char mqttHost[MQTT_HOSTNAME_LEN + 1];
  bool mqttUseTls;
  bool mqttInsecure;
  uint16_t mqttServerPort;
  uint16_t altitude;
  uint16_t co2GreenThreshold;
  uint16_t co2YellowThreshold;
  uint16_t co2RedThreshold;
  uint16_t co2DarkRedThreshold;
  uint16_t iaqGreenThreshold;
  uint16_t iaqYellowThreshold;
  uint16_t iaqRedThreshold;
  uint16_t iaqDarkRedThreshold;
  uint8_t brightness;
  uint8_t ssd1306Rows;
  uint8_t greenLed;
  uint8_t yellowLed;
  uint8_t redLed;
  uint8_t neopixelData;
  uint8_t neopixelNumber;
  uint8_t neopixelMatrixData;
  uint8_t featherMatrixData;
  uint8_t featherMatrixClock;
  uint8_t matrixColumns;
  uint8_t matrixRows;
  uint8_t matrixLayout;
  uint8_t hub75R1;
  uint8_t hub75G1;
  uint8_t hub75B1;
  uint8_t hub75R2;
  uint8_t hub75G2;
  uint8_t hub75B2;
  uint8_t hub75ChA;
  uint8_t hub75ChB;
  uint8_t hub75ChC;
  uint8_t hub75ChD;
  uint8_t hub75Clk;
  uint8_t hub75Lat;
  uint8_t hub75Oe;
};

#endif
