oseiler2/CO2Monitor/include/smileys.h

// 'smiley_green', 32x32px, colur green: 0x0fc0
const unsigned char smiley_green_bitmap[] PROGMEM = {
  0b00000000, 0b00000000, 0b00000000, 0b00000000, 
  0b00000000, 0b00001111, 0b11110000, 0b00000000, 
  0b00000000, 0b01111111, 0b11111110, 0b00000000, 
  0b00000000, 0b11111111, 0b11111111, 0b00000000, 
  0b00000011, 0b11111111, 0b11111111, 0b11000000, 
  0b00000111, 0b11111111, 0b11111111, 0b11100000, 
  0b00001111, 0b11111111, 0b11111111, 0b11110000, 
  0b00001111, 0b11111111, 0b11111111, 0b11110000, 
  0b00011111, 0b10001111, 0b11110001, 0b11111000, 
  0b00111111, 0b00000111, 0b11100000, 0b11111100, 
  0b00111111, 0b00000111, 0b11100000, 0b11111100, 
  0b00111111, 0b00000111, 0b11100000, 0b11111100, 
  0b01111111, 0b10001111, 0b11110001, 0b11111110, 
  0b01111111, 0b11111111, 0b11111111, 0b11111110, 
  0b01111111, 0b11111111, 0b11111111, 0b11111110, 
  0b01111111, 0b11111111, 0b11111111, 0b11111110, 
  0b01111111, 0b11111111, 0b11111111, 0b11111110, 
  0b01111111, 0b11111111, 0b11111111, 0b11111110, 
  0b01111111, 0b11111111, 0b11111111, 0b11111110, 
  0b01111111, 0b11111111, 0b11111111, 0b11111110, 
  0b00111111, 0b00111111, 0b11111100, 0b11111100, 
  0b00111111, 0b00111111, 0b11111100, 0b11111100, 
  0b00111111, 0b10011111, 0b11111001, 0b11111100, 
  0b00011111, 0b11001111, 0b11110011, 0b11111000, 
  0b00001111, 0b11100000, 0b00000111, 0b11110000, 
  0b00001111, 0b11110000, 0b00001111, 0b11110000, 
  0b00000111, 0b11111111, 0b11111111, 0b11100000, 
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
  0b00111111, 0b11111111, 0b11111111, 0b11111111, 0b11111111, 0b11111111, 0b11111111, 0b11111100,
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
};

const uint8_t* smileys_bitmap_64[4] = {
  smiley_green_bitmap_64,
  smiley_yellow_bitmap_64,
  smiley_red_bitmap_64,
  smiley_dark_red_bitmap_64
};
