oseiler2/CO2Monitor/src/mqtt.cpp

#include <mqtt.h>
#include <Arduino.h>
#include <config.h>

#include <PubSubClient.h>
#include <WiFiClient.h>
#include <WiFiClientSecure.h>
#include <i2c.h>
#include <configManager.h>
#include <wifiManager.h>
#include <ota.h>

#include <LittleFS.h>

// Local logging tag
static const char TAG[] = __FILE__;

namespace mqtt {

  struct MqttMessage {
    uint8_t cmd;
    DynamicJsonDocument* payload;
    char* statusMessage;
  };

  const uint8_t X_CMD_PUBLISH_SENSORS = bit(0);
  const uint8_t X_CMD_PUBLISH_CONFIGURATION = bit(1);
  const uint8_t X_CMD_PUBLISH_STATUS_MSG = bit(2);

  TaskHandle_t mqttTask;
  QueueHandle_t mqttQueue;

  WiFiClient* wifiClient;
  PubSubClient* mqtt_client;

  calibrateCo2SensorCallback_t calibrateCo2SensorCallback;
  setTemperatureOffsetCallback_t setTemperatureOffsetCallback;
  getTemperatureOffsetCallback_t getTemperatureOffsetCallback;
  getSPS30AutoCleanIntervalCallback_t getSPS30AutoCleanIntervalCallback;
  setSPS30AutoCleanIntervalCallback_t setSPS30AutoCleanIntervalCallback;
  cleanSPS30Callback_t cleanSPS30Callback;
  getSPS30StatusCallback_t getSPS30StatusCallback;
  configChangedCallback_t configChangedCallback;

  uint32_t lastReconnectAttempt = 0;
  uint16_t connectionAttempts = 0;

  char* cloneStr(const char* original) {
    char* copy = (char*)malloc(strlen(original) + 1);
    strncpy(copy, original, strlen(original));
    copy[strlen(original)] = 0x00;
    return copy;
  }

  void publishSensors(DynamicJsonDocument* _payload) {
    if (!WiFi.isConnected() || !mqtt_client->connected()) {
      delete _payload;
      return;
    }
    MqttMessage msg;
    msg.cmd = X_CMD_PUBLISH_SENSORS;
    msg.payload = _payload;
    if (!mqttQueue || !xQueueSendToBack(mqttQueue, (void*)&msg, pdMS_TO_TICKS(100))) {
      delete msg.payload;
    }
  }

  boolean publishSensorsInternal(MqttMessage queueMsg) {
    char topic[256];
    char msg[256];
    sprintf(topic, "%s/%u/up/sensors", config.mqttTopic, config.deviceId);

    // Serialize JSON to file
    if (serializeJson(*queueMsg.payload, msg) == 0) {
      ESP_LOGW(TAG, "Failed to serialise payload");
      delete queueMsg.payload;
      return true; // pretend to have been successful to prevent queue from clogging up
    }
    if (strncmp(msg, "null", 4) == 0) {
      ESP_LOGD(TAG, "Nothing to publish");
      delete queueMsg.payload;
      return true; // pretend to have been successful to prevent queue from clogging up
    }
    ESP_LOGD(TAG, "Publishing sensor values: %s:%s", topic, msg);
    if (!mqtt_client->publish(topic, msg)) {
      ESP_LOGI(TAG, "publish sensors failed!");
      return false;
    }
    delete queueMsg.payload;
    return true;
  }

  void publishConfiguration() {
    MqttMessage msg;
    msg.cmd = X_CMD_PUBLISH_CONFIGURATION;
    msg.statusMessage = nullptr;
    if (mqttQueue) xQueueSendToBack(mqttQueue, (void*)&msg, pdMS_TO_TICKS(100));
  }

  void setMqttCerts(WiFiClientSecure* wifiClient, const char* mqttRootCertFilename, const char* mqttClientKeyFilename, const char* mqttClientCertFilename) {
    File root_ca_file = LittleFS.open(mqttRootCertFilename, FILE_READ);
    if (root_ca_file) {
      ESP_LOGD(TAG, "Loading MQTT root ca from FS (%s)", mqttRootCertFilename);
      wifiClient->loadCACert(root_ca_file, root_ca_file.size());
      root_ca_file.close();
    }
    File client_key_file = LittleFS.open(mqttClientKeyFilename, FILE_READ);
    if (client_key_file) {
      ESP_LOGD(TAG, "Loading MQTT client key from FS (%s)", mqttClientKeyFilename);
      wifiClient->loadPrivateKey(client_key_file, client_key_file.size());
      client_key_file.close();
    }
    File client_cert_file = LittleFS.open(mqttClientCertFilename, FILE_READ);
    if (client_cert_file) {
      ESP_LOGD(TAG, "Loading MQTT client cert from FS (%s)", mqttClientCertFilename);
      wifiClient->loadCertificate(client_cert_file, client_cert_file.size());
      client_cert_file.close();
    }
  }

  boolean testMqttConfig(WiFiClient* wifiClient, Config testConfig) {
    char buf[128];
    boolean mqttTestSuccess;
    PubSubClient* testMqttClient = new PubSubClient(*wifiClient);
    testMqttClient->setServer(testConfig.mqttHost, testConfig.mqttServerPort);
    sprintf(buf, "CO2Monitor-%u-%s", testConfig.deviceId, WifiManager::getMac().c_str());
    // disconnect current connection if not enough heap avalable to initiate another tls session.
    if (testConfig.mqttUseTls && ESP.getFreeHeap() < 75000) mqtt_client->disconnect();
    mqttTestSuccess = testMqttClient->connect(buf, testConfig.mqttUsername, testConfig.mqttPassword);
    if (mqttTestSuccess) {
      ESP_LOGD(TAG, "Test MQTT connected");
      sprintf(buf, "%s/%u/up/status", testConfig.mqttTopic, testConfig.deviceId);
      mqttTestSuccess = testMqttClient->publish(buf, "{\"test\":true}");
      if (!mqttTestSuccess) ESP_LOGI(TAG, "connecting using new mqtt settings failed!");
    }
    delete testMqttClient;
    return mqttTestSuccess;
  }

  boolean publishConfigurationInternal() {
    char buf[256];
    char msg[CONFIG_SIZE];
    DynamicJsonDocument doc(CONFIG_SIZE);
    doc["appVersion"] = APP_VERSION;
    sprintf(buf, "%s", WifiManager::getMac().c_str());
    doc["mac"] = buf;
    sprintf(buf, "%s", WiFi.localIP().toString().c_str());
    doc["ip"] = buf;
    if (I2C::scd30Present())
      doc["scd30"] = true;
    if (I2C::scd40Present())
      doc["scd40"] = true;
    if (I2C::bme680Present())
      doc["bme680"] = true;
    if (I2C::lcdPresent())
      doc["lcd"] = true;
    if (I2C::sps30Present()) {
      doc["sps30"] = true;
      doc["sps30AutoCleanInt"] = getSPS30AutoCleanIntervalCallback();
      doc["sps30Status"] = getSPS30StatusCallback();
    }

    for (ConfigParameterBase<Config>* configParameter : getConfigParameters()) {
      if (!(strncmp(configParameter->getId(), "deviceId", strlen(buf)) == 0)
        && !(strncmp(configParameter->getId(), "mqttPassword", strlen(buf)) == 0))
        configParameter->toJson(config, &doc);
    }

    float tempOffset = getTemperatureOffsetCallback();
    if (tempOffset != NaN) {
      sprintf(buf, "%.1f", getTemperatureOffsetCallback());
      doc["tempOffset"] = buf;
    }
    if (serializeJson(doc, msg) == 0) {
      ESP_LOGW(TAG, "Failed to serialise payload");
      return true; // pretend to have been successful to prevent queue from clogging up
    }
    sprintf(buf, "%s/%u/up/config", config.mqttTopic, config.deviceId);
    ESP_LOGI(TAG, "Publishing configuration: %s:%s", buf, msg);
    if (!mqtt_client->publish(buf, msg)) {
      ESP_LOGI(TAG, "publish configuration failed!");
      return false;
    }
    return true;
  }

  void publishStatusMsg(const char* statusMessage) {
    if (strlen(statusMessage) > 200) {
      ESP_LOGW(TAG, "msg too long - discarding");
      return;
    }
    MqttMessage msg;
    msg.cmd = X_CMD_PUBLISH_STATUS_MSG;
    msg.statusMessage = cloneStr(statusMessage);
    if (!mqttQueue || !xQueueSendToBack(mqttQueue, (void*)&msg, pdMS_TO_TICKS(100))) {
      free(msg.statusMessage);
    }
  }

  boolean publishStatusMsgInternal(char* statusMessage, boolean keepOnFailure) {
    if (strlen(statusMessage) > 200) {
      free(statusMessage);
      return true;// pretend to have been successful to prevent queue from clogging up
    }
    char topic[256];
    sprintf(topic, "%s/%u/up/status", config.mqttTopic, config.deviceId);
    char msg[256];
    DynamicJsonDocument doc(CONFIG_SIZE);
    doc["msg"] = statusMessage;
    if (serializeJson(doc, msg) == 0) {
      ESP_LOGW(TAG, "Failed to serialise payload");
      free(statusMessage);
      return true;// pretend to have been successful to prevent queue from clogging up
    }
    if (!mqtt_client->publish(topic, msg)) {
      ESP_LOGI(TAG, "publish status msg failed!");
      if (!keepOnFailure) free(statusMessage);
      // don't free heap, since message will be re-tried
      return false;
    }
    free(statusMessage);
    return true;
  }

  // Helper to write a file to fs
  bool writeFile(const char* name, unsigned char* contents) {
    File f;
    if (!(f = LittleFS.open(name, FILE_WRITE))) {
      return false;
    }
    int len = strlen((char*)contents);
    if (f.write(contents, len) != len) {
      f.close();
      return false;
    }
    f.close();
    return true;
  }

  void callback(char* topic, byte* payload, unsigned int length) {
    char buf[256];
    char msg[length + 1];
    strncpy(msg, (char*)payload, length);
    msg[length] = 0x00;
    ESP_LOGI(TAG, "Message arrived [%s] %s", topic, msg);

    sprintf(buf, "%s/%u/down/", config.mqttTopic, config.deviceId);
    int16_t cmdIdx = -1;
    if (strncmp(topic, buf, strlen(buf)) == 0) {
      ESP_LOGI(TAG, "Device specific downlink message arrived [%s]", topic);
      cmdIdx = strlen(buf);
    }
    sprintf(buf, "%s/down/", config.mqttTopic);
    if (strncmp(topic, buf, strlen(buf)) == 0) {
      ESP_LOGI(TAG, "Device agnostic downlink message arrived [%s]", topic);
      cmdIdx = strlen(buf);
    }
    if (cmdIdx < 0) return;
    strncpy(buf, topic + cmdIdx, strlen(topic) - cmdIdx + 1);
    ESP_LOGI(TAG, "Received command [%s]", buf);

    if (strncmp(buf, "calibrate", strlen(buf)) == 0) {
      int reference = atoi(msg);
      if (reference >= 400 && reference <= 2000) {
        calibrateCo2SensorCallback(reference);
      }
    } else if (strncmp(buf, "setTemperatureOffset", strlen(buf)) == 0) {
      float tempOffset = atof(msg);
      if (0.0 <= tempOffset && tempOffset <= 10.0) {
        setTemperatureOffsetCallback(tempOffset);
      }
    } else if (strncmp(buf, "setSPS30AutoCleanInterval", strlen(buf)) == 0) {
      char* eptr;
      long interval = std::strtoul(msg, &eptr, 10);
      setSPS30AutoCleanIntervalCallback(interval);
    } else if (strncmp(buf, "cleanSPS30", strlen(buf)) == 0) {
      cleanSPS30Callback();
    } else if (strncmp(buf, "getConfig", strlen(buf)) == 0) {
      publishConfiguration();
    } else if (strncmp(buf, "setConfig", strlen(buf)) == 0) {
      DynamicJsonDocument doc(CONFIG_SIZE);
      DeserializationError error = deserializeJson(doc, msg);
      if (error) {
        ESP_LOGW(TAG, "Failed to parse message: %s", error.f_str());
        return;
      }

      bool rebootRequired = false;
      Config mqttConfig = config;
      bool mqttConfigUpdated = false;
      for (ConfigParameterBase<Config>* configParameter : getConfigParameters()) {
        if (strncmp(configParameter->getId(), "mqttHost", strlen(buf)) == 0
          || strncmp(configParameter->getId(), "mqttServerPort", strlen(buf)) == 0
          || strncmp(configParameter->getId(), "deviceId", strlen(buf)) == 0
          || strncmp(configParameter->getId(), "mqttUsername", strlen(buf)) == 0
          || strncmp(configParameter->getId(), "mqttPassword", strlen(buf)) == 0
          || strncmp(configParameter->getId(), "mqttTopic", strlen(buf)) == 0
          || strncmp(configParameter->getId(), "mqttUseTls", strlen(buf)) == 0
          || strncmp(configParameter->getId(), "mqttInsecure", strlen(buf)) == 0) {
          mqttConfigUpdated |= configParameter->fromJson(mqttConfig, &doc, false);
          if (configParameter->fromJson(mqttConfig, &doc, false))
            ESP_LOGI(TAG, "MQTT Config %s updated to %s", configParameter->getId(), configParameter->toString(mqttConfig).c_str());
        } else {
          rebootRequired |= (configParameter->fromJson(config, &doc, false) && configParameter->isRebootRequiredOnChange());
          if (configParameter->fromJson(config, &doc, false))
            ESP_LOGI(TAG, "Config %s updated to %s. Reboot needed? %s", configParameter->getId(), configParameter->toString(config).c_str(), configParameter->isRebootRequiredOnChange() ? "true" : "false");
        }
      }
      bool mqttTestSuccess = true;

      if (mqttConfigUpdated) {
        WiFiClient* testWifiClient;
        if (mqttConfig.mqttUseTls) {
          testWifiClient = new WiFiClientSecure();
          if (mqttConfig.mqttInsecure) {
            ((WiFiClientSecure*)testWifiClient)->setInsecure();
          }
          setMqttCerts((WiFiClientSecure*)testWifiClient, MQTT_ROOT_CA_FILENAME, MQTT_CLIENT_KEY_FILENAME, MQTT_CLIENT_CERT_FILENAME);
        } else {
          testWifiClient = new WiFiClient();
        }
        mqttTestSuccess = testMqttConfig(testWifiClient, mqttConfig);
        delete testWifiClient;
        if (mqttTestSuccess) {
          config = mqttConfig;
          rebootRequired = true;
        }
      }
      if (saveConfiguration(config) && rebootRequired) {
        publishStatusMsgInternal(cloneStr("configuration updated - rebooting shortly"), false);
        delay(2000);
        esp_restart();
      }
      configChangedCallback();
    } else if (strncmp(buf, "installMqttRootCa", strlen(buf)) == 0) {
      ESP_LOGD(TAG, "installMqttRootCa");
      if (!writeFile(TEMP_MQTT_ROOT_CA_FILENAME, (unsigned char*)&msg[0])) {
        ESP_LOGW(TAG, "Error writing mqtt root ca");
        publishStatusMsgInternal(cloneStr("Error writing cert to FS"), false);
        return;
      }
      bool mqttTestSuccess = config.mqttInsecure || !config.mqttUseTls; // no need to test if not using tls, or not checking certs
      if (config.mqttUseTls && !config.mqttInsecure) {
        ESP_LOGD(TAG, "test connection using new ca");
        // test connection using cert
        WiFiClientSecure* testWifiClient = new WiFiClientSecure();
        setMqttCerts(testWifiClient, TEMP_MQTT_ROOT_CA_FILENAME, MQTT_CLIENT_KEY_FILENAME, MQTT_CLIENT_CERT_FILENAME);
        mqttTestSuccess = testMqttConfig(testWifiClient, config);
        delete testWifiClient;
      }
      ESP_LOGD(TAG, "mqttTestSuccess %u", mqttTestSuccess);
      if (mqttTestSuccess) {
        if (LittleFS.exists(MQTT_ROOT_CA_FILENAME) && !LittleFS.remove(MQTT_ROOT_CA_FILENAME)) {
          ESP_LOGE(TAG, "Failed to remove original CA file");
          publishStatusMsgInternal(cloneStr("Could not remove original CA - giving up"), false);
          return;  // leave old file in place and give up.
        }
        if (!LittleFS.rename(TEMP_MQTT_ROOT_CA_FILENAME, MQTT_ROOT_CA_FILENAME)) {
          publishStatusMsgInternal(cloneStr("Could not replace original CA with new CA - PANIC - giving up"), false);
          ESP_LOGE(TAG, "Failed to move temporary CA file");
          config.mqttInsecure = true;
          saveConfiguration(config);
          delay(2000);
          esp_restart();
          return;
        }
        ESP_LOGI(TAG, "installed and tested new CA, rebooting shortly");
        publishStatusMsgInternal(cloneStr("installed and tested new CA - rebooting shortly"), false);
        delay(2000);
        esp_restart();
      } else {
        ESP_LOGI(TAG, "publish connect msg failed!");
        publishStatusMsgInternal(cloneStr("Connecting using the new CA failed - reverting"), false);
        if (!LittleFS.remove(TEMP_MQTT_ROOT_CA_FILENAME)) ESP_LOGW(TAG, "Failed to remove temporary CA file");
      }
    } else if (strncmp(buf, "installRootCa", strlen(buf)) == 0) {
      ESP_LOGD(TAG, "installRootCa");
      if (!writeFile(ROOT_CA_FILENAME, (unsigned char*)&msg[0])) {
        ESP_LOGW(TAG, "Error writing root ca");
        publishStatusMsgInternal(cloneStr("Error writing cert to FS"), false);
      }
    } else if (strncmp(buf, "resetWifi", strlen(buf)) == 0) {
      WifiManager::resetSettings();
    } else if (strncmp(buf, "ota", strlen(buf)) == 0) {
      OTA::checkForUpdate();
    } else if (strncmp(buf, "forceota", strlen(buf)) == 0) {
      OTA::forceUpdate(msg);
    } else if (strncmp(buf, "reboot", strlen(buf)) == 0) {
      esp_restart();
    }
  }

  void reconnect() {
    if (!WiFi.isConnected() || mqtt_client->connected()) return;
    if (millis() - lastReconnectAttempt < 60000) return;
    if (strncmp(config.mqttHost, "127.0.0.1", MQTT_HOSTNAME_LEN) == 0 ||
      strncmp(config.mqttHost, "localhost", MQTT_HOSTNAME_LEN) == 0) return;
    char topic[256];
    char id[64];
    sprintf(id, "CO2Monitor-%u-%s", config.deviceId, WifiManager::getMac().c_str());
    lastReconnectAttempt = millis();
    ESP_LOGD(TAG, "Attempting MQTT connection...");
    connectionAttempts++;
    sprintf(topic, "%s/%u/up/status", config.mqttTopic, config.deviceId);
    if (mqtt_client->connect(id, config.mqttUsername, config.mqttPassword, topic, 1, false, "{\"msg\":\"disconnected\"}")) {
      ESP_LOGD(TAG, "MQTT connected");
      sprintf(topic, "%s/%u/down/#", config.mqttTopic, config.deviceId);
      mqtt_client->subscribe(topic);
      sprintf(topic, "%s/down/#", config.mqttTopic);
      mqtt_client->subscribe(topic);
      sprintf(topic, "%s/%u/up/status", config.mqttTopic, config.deviceId);
      char msg[256];
      DynamicJsonDocument doc(CONFIG_SIZE);
      doc["online"] = true;
      doc["connectionAttempts"] = connectionAttempts;
      if (serializeJson(doc, msg) == 0) {
        ESP_LOGW(TAG, "Failed to serialise payload");
        return;
      }
      if (mqtt_client->publish(topic, msg))
        connectionAttempts = 0;
      else
        ESP_LOGI(TAG, "publish connect msg failed!");
    } else {
      ESP_LOGW(TAG, "MQTT connection failed, rc=%i", mqtt_client->state());
      vTaskDelay(pdMS_TO_TICKS(1000));
    }
  }

  void logCallback(int level, const char* tag, const char* message) {
    publishStatusMsg(message);
  }

  void setupMqtt(
    calibrateCo2SensorCallback_t _calibrateCo2SensorCallback,
    setTemperatureOffsetCallback_t _setTemperatureOffsetCallback,
    getTemperatureOffsetCallback_t _getTemperatureOffsetCallback,
    getSPS30AutoCleanIntervalCallback_t _getSPS30AutoCleanIntervalCallback,
    setSPS30AutoCleanIntervalCallback_t _setSPS30AutoCleanIntervalCallback,
    cleanSPS30Callback_t _cleanSPS30Callback,
    getSPS30StatusCallback_t _getSPS30StatusCallback,
    configChangedCallback_t _configChangedCallback
  ) {
    mqttQueue = xQueueCreate(MQTT_QUEUE_LENGTH, sizeof(struct MqttMessage));
    if (mqttQueue == NULL) {
      ESP_LOGE(TAG, "Queue creation failed!");
    }

    calibrateCo2SensorCallback = _calibrateCo2SensorCallback;
    setTemperatureOffsetCallback = _setTemperatureOffsetCallback;
    getTemperatureOffsetCallback = _getTemperatureOffsetCallback;
    getSPS30AutoCleanIntervalCallback = _getSPS30AutoCleanIntervalCallback;
    setSPS30AutoCleanIntervalCallback = _setSPS30AutoCleanIntervalCallback;
    cleanSPS30Callback = _cleanSPS30Callback;
    getSPS30StatusCallback = _getSPS30StatusCallback;
    configChangedCallback = _configChangedCallback;

    if (config.mqttUseTls) {
      wifiClient = new WiFiClientSecure();
      if (config.mqttInsecure) {
        ((WiFiClientSecure*)wifiClient)->setInsecure();
      }
      setMqttCerts((WiFiClientSecure*)wifiClient, MQTT_ROOT_CA_FILENAME, MQTT_CLIENT_KEY_FILENAME, MQTT_CLIENT_CERT_FILENAME);
    } else {
      wifiClient = new WiFiClient();
    }

    mqtt_client = new PubSubClient(*wifiClient);
    mqtt_client->setServer(config.mqttHost, config.mqttServerPort);
    mqtt_client->setCallback(callback);
    if (!mqtt_client->setBufferSize(MQTT_BUFFER_SIZE)) ESP_LOGE(TAG, "mqtt_client->setBufferSize failed!");

    //    logging::addOnLogCallback(logCallback);
  }

  void mqttLoop(void* pvParameters) {
    _ASSERT((uint32_t)pvParameters == 1);
    lastReconnectAttempt = millis() - 60000;
    BaseType_t notified;
    MqttMessage msg;
    while (1) {
      notified = xQueuePeek(mqttQueue, &msg, pdMS_TO_TICKS(100));
      if (notified == pdPASS) {
        if (mqtt_client->connected()) {
          if (msg.cmd == X_CMD_PUBLISH_CONFIGURATION) {
            if (publishConfigurationInternal()) {
              xQueueReceive(mqttQueue, &msg, pdMS_TO_TICKS(100));
            }
          } else if (msg.cmd == X_CMD_PUBLISH_SENSORS) {
            // don't keep measurements in the queue should they fail to be published
            publishSensorsInternal(msg);
            xQueueReceive(mqttQueue, &msg, pdMS_TO_TICKS(100));
          } else if (msg.cmd == X_CMD_PUBLISH_STATUS_MSG) {
            // keep status messages in the queue should they fail to be published
            if (publishStatusMsgInternal(msg.statusMessage, true)) {
              xQueueReceive(mqttQueue, &msg, pdMS_TO_TICKS(100));
            }
          }
        }
      }
      if (!mqtt_client->connected()) {
        reconnect();
      }
      mqtt_client->loop();
      vTaskDelay(pdMS_TO_TICKS(50));
    }
    vTaskDelete(NULL);
  }
}
