oseiler2/CO2Monitor/include/message.h

// 'dang', 32x16px
const unsigned char msg_dang [] PROGMEM = {
	0x00, 0x00, 0x00, 0x00, 0x00, 0x00, 0x00, 0x00, 0x7c, 0x3c, 0x66, 0x3c, 0x7c, 0x7e, 0x66, 0x7e, 
	0x66, 0x66, 0x76, 0x66, 0x66, 0x66, 0x76, 0x60, 0x66, 0x66, 0x76, 0x60, 0x66, 0x7e, 0x7e, 0x60, 
	0x66, 0x7e, 0x7e, 0x6e, 0x66, 0x66, 0x6e, 0x6e, 0x66, 0x66, 0x6e, 0x66, 0x66, 0x66, 0x6e, 0x66, 
	0x7c, 0x66, 0x66, 0x7e, 0x7c, 0x66, 0x66, 0x3c, 0x00, 0x00, 0x00, 0x00, 0x00, 0x00, 0x00, 0x00
};

// 'good', 32x16px
const unsigned char msg_good [] PROGMEM = {
	0x00, 0x00, 0x00, 0x00, 0x00, 0x00, 0x00, 0x00, 0x3c, 0x3c, 0x3c, 0x7c, 0x7e, 0x7e, 0x7e, 0x7c, 
	0x66, 0x66, 0x66, 0x66, 0x60, 0x66, 0x66, 0x66, 0x60, 0x66, 0x66, 0x66, 0x60, 0x66, 0x66, 0x66, 
	0x6e, 0x66, 0x66, 0x66, 0x6e, 0x66, 0x66, 0x66, 0x66, 0x66, 0x66, 0x66, 0x66, 0x66, 0x66, 0x66, 
	0x7e, 0x7e, 0x7e, 0x7c, 0x3c, 0x3c, 0x3c, 0x7c, 0x00, 0x00, 0x00, 0x00, 0x00, 0x00, 0x00, 0x00
};
// 'warn', 32x16px
const unsigned char msg_warn [] PROGMEM = {
	0x00, 0x00, 0x00, 0x00, 0x00, 0x00, 0x00, 0x00, 0xc3, 0x3c, 0x7c, 0x66, 0xc3, 0x7e, 0x7c, 0x66, 
	0xc3, 0x66, 0x66, 0x76, 0xc3, 0x66, 0x66, 0x76, 0xc3, 0x66, 0x66, 0x76, 0xc3, 0x7e, 0x7e, 0x7e, 
	0xc3, 0x7e, 0x7c, 0x7e, 0xdb, 0x66, 0x6c, 0x6e, 0xdb, 0x66, 0x66, 0x6e, 0xff, 0x66, 0x66, 0x6e, 
	0x66, 0x66, 0x66, 0x66, 0x66, 0x66, 0x66, 0x66, 0x00, 0x00, 0x00, 0x00, 0x00, 0x00, 0x00, 0x00
};
// 'poor', 32x16px
const unsigned char msg_poor [] PROGMEM = {
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
	0xf0, 0x0f, 0x3f, 0xfc, 0x3f, 0xfc, 0x3f, 0xfc, 0xf0, 0x0f, 0x3f, 0xfc, 0x3f, 0xfc, 0x3f, 0xfc, 
	0xf0, 0x0f, 0x3f, 0xfc, 0x3f, 0xf0, 0x3f, 0xfc, 0xf0, 0x0f, 0x3f, 0xfc, 0x3f, 0xf0, 0x3f, 0xfc, 
	0xf3, 0xcf, 0x3c, 0x3c, 0x3c, 0xf0, 0x3c, 0xfc, 0xf3, 0xcf, 0x3c, 0x3c, 0x3c, 0xf0, 0x3c, 0xfc, 
	0xf3, 0xcf, 0x3c, 0x3c, 0x3c, 0x3c, 0x3c, 0xfc, 0xf3, 0xcf, 0x3c, 0x3c, 0x3c, 0x3c, 0x3c, 0xfc, 
	0xff, 0xff, 0x3c, 0x3c, 0x3c, 0x3c, 0x3c, 0xfc, 0xff, 0xff, 0x3c, 0x3c, 0x3c, 0x3c, 0x3c, 0xfc, 
	0x3c, 0x3c, 0x3c, 0x3c, 0x3c, 0x3c, 0x3c, 0x3c, 0x3c, 0x3c, 0x3c, 0x3c, 0x3c, 0x3c, 0x3c, 0x3c, 
	0x3c, 0x3c, 0x3c, 0x3c, 0x3c, 0x3c, 0x3c, 0x3c, 0x3c, 0x3c, 0x3c, 0x3c, 0x3c, 0x3c, 0x3c, 0x3c, 
	0x00, 0x00, 0x00, 0x00, 0x00, 0x00, 0x00, 0x00, 0x00, 0x00, 0x00, 0x00, 0x00, 0x00, 0x00, 0x00, 
	0x00, 0x00, 0x00, 0x00, 0x00, 0x00, 0x00, 0x00, 0x00, 0x00, 0x00, 0x00, 0x00, 0x00, 0x00, 0x00
};


// Array of all bitmaps for convenience. (Total bytes used to store images in PROGMEM = 320)
const unsigned char* messages[4] = {
  msg_good,
  msg_poor,
  msg_warn,
  msg_dang
};

const unsigned char* messages_64[4] = {
  msg_good_64,
  msg_poor_64,
  msg_warn_64,
  msg_dang_64
};
