oseiler2/CO2Monitor/include/configManager.h

#ifndef _CONFIG_MANAGER_H
#define _CONFIG_MANAGER_H

#include <Arduino.h>
#include <config.h>
#include <configParameter.h>
#include <vector>

extern Config config;

void setupConfigManager();
void getDefaultConfiguration(Config& config);
boolean loadConfiguration(Config& config);
boolean saveConfiguration(const Config config);
void logConfiguration(const Config config);
void printFile();
std::vector<ConfigParameterBase<Config>*> getConfigParameters();

#endif
