oseiler2/CO2Monitor/include/ota.h

#ifndef _OTA_H
#define _OTA_H

#include <globals.h>
#include <messageSupport.h>

typedef void (*preUpdateCallback_t)(void);

namespace OTA {
  void setupOta(preUpdateCallback_t preUpdateCallback, setPriorityMessageCallback_t _setPriorityMessageCallback, clearPriorityMessageCallback_t _clearPriorityMessageCallback);
  void checkForUpdate();
  extern TaskHandle_t otaTask;
  void otaLoop(void* pvParameters);
  void forceUpdate(char* url);
}

#endif
