oseiler2/CO2Monitor/post_build.py

# Source https://github.com/letscontrolit/ESPEasy/pull/3845#issuecomment-1005864664

import os
if os.environ.get("ESPHOME_USE_SUBPROCESS") is None:
    import esptool
else:
    import subprocess
from SCons.Script import ARGUMENTS

# pylint: disable=E0602
Import("env")  # noqa


def esp32_create_combined_bin(source, target, env):
    verbose = bool(int(ARGUMENTS.get("PIOVERBOSE", "0")))
    if verbose:
        print("Generating combined binary for serial flashing")
    app_offset = 0x10000

    new_file_name = env.subst("$BUILD_DIR/${PROGNAME}-combined.bin")
    sections = env.subst(env.get("FLASH_EXTRA_IMAGES"))
    firmware_name = env.subst("$BUILD_DIR/${PROGNAME}.bin")
    chip = env.get("BOARD_MCU")
    flash_size = env.BoardConfig().get("upload.flash_size")
    cmd = [
        "--chip",
        chip,
        "merge_bin",
        "-o",
        new_file_name,
        "--flash_size",
        flash_size,
    ]
    if verbose:
        print("    Offset | File")
    for section in sections:
        sect_adr, sect_file = section.split(" ", 1)
        if verbose:
            print(f" -  {sect_adr} | {sect_file}")
        cmd += [sect_adr, sect_file]

    cmd += [hex(app_offset), firmware_name]

    if verbose:
        print(f" - {hex(app_offset)} | {firmware_name}")
        print()
        print(f"Using esptool.py arguments: {' '.join(cmd)}")
        print()

    if os.environ.get("ESPHOME_USE_SUBPROCESS") is None:
        esptool.main(cmd)
    else:
        subprocess.run(["esptool.py", *cmd])

# pylint: disable=E0602
env.AddPostAction("$BUILD_DIR/${PROGNAME}.bin", esp32_create_combined_bin)  # noqa
