oseiler2/CO2Monitor/(commit log)

2021-12-18 fix feather matrix when undefined
    [featherMatrix.cpp]
2021-12-20 Enable PWM for LEDs
2021-12-23 fix dark red flash pattern
    [trafficLight.cpp]
2021-12-24 Configure LED brightness remotely
2021-12-26 BME680 use primary I2C address
2021-12-26 fix led alternating
2021-12-29 Set temperature offset for SCD30/4x remotely
2022-01-15 Update pin#s
2022-01-15 Case and panel models
2022-01-19 added reset wifi command
    [main.cpp, mqtt.cpp, wifiManager.h]
2022-01-20 Customs partition table for larger app image
    [partitions.csv]
2022-01-21 Fix mqtt dns resolution issue
    [mqtt.cpp]
2022-01-25 stop hub75 DMA before OTA and config portal
2022-02-05 Align neopixel amber colour temp closer to amber LED
2022-04-08 V0.3 PCB design plus doc
    [CO2Monitor V0.1.brd, CO2Monitor V0.1.sch, CO2Monitor V0.3.brd, CO2Monitor V0.3.sch]
2022-05-02 Added BOM for through hole board
2022-05-02 minor BOM update
2022-05-08 Minor improvements and fixes
    [mqtt.cpp]
2022-05-08 case v0.3
2022-05-10 Updated case and docs
    [Case v0.3_10mm.STL]
2022-05-10 Added photo to bom
2022-05-19 fix default brightness value
    [configManager.cpp]
2022-05-20 added temperature offset to getConfig message
2022-05-21 pin esp32FOTA 0.1.5
2022-05-21 Fix missing log tags
    [bme680.cpp, configManager.cpp, housekeeping.cpp, hub75.cpp, i2c.cpp, main.cpp, model.cpp, mqtt.cpp]
2022-05-21 pin framework to 3.5
2022-05-25 Updated documentation and STL for SPS30
2022-05-25 Added calibration documentation
2022-05-25 fix LittleFS lib dependency
    [main.cpp]
2022-06-01 fix: AP always active + use full mac for ssid
    [main.cpp, mqtt.cpp, wifiManager.h]
2022-06-02 prevent negative temperature offset, persist SCD40
    [mqtt.cpp, scd30.cpp, scd40.cpp]
2022-06-03 fix: USB flash doesn't override OTA flashed image
    The custom partition table was placing the otadata partition at a non-standard
    offset (0xd000) which doesn't match the hardcoded location the arduino esp32
    platform setup expects it to be when flashing (0xe000) per
    https://github.com/espressif/arduino-esp32/blob/master/tools/platformio-build-esp32.py#L332
    This means flashing via USB was putting the boot_app0.bin config into the 2nd
    half of the otadata partition and then overwriting into the phy_init partition
    (which isn't being used anyway), if you'd previously OTA'd and the boot from
    ota_1 flag was set in otadata (presumably in the first half that wasn't being
    written to), the result was th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
    [partitions.csv]
2022-06-03 set pinMode before pwm configuration
2022-06-03 reboot when hw configuration changes
    [mqtt.cpp]
2022-06-09 V0.4 cases with USB port cut out
    [Case v0.3_10mm.STL, Case v0.4_10mm_cable.STL, Case v0.4_15mmSPS30_USB.STL, Case v0.4_15mm_USB.STL, Case v0.4_15mm_cable.STL]
2022-06-10 fix: priority message stopping updates 32 row lcd
    [lcd.cpp]
2022-06-16 New PCB revision 0.5
    [B5B-ZR_LF__SN_.step, BME680.step, CO2Monitor SMD V0.5.kicad_pcb, CO2Monitor SMD V0.5.kicad_sch, CO2Monitor TH V0.5.kicad_pcb, CO2Monitor TH V0.5.kicad_sch, CO2Monitor V0.1.brd, CO2Monitor V0.1.sch]
2022-06-20 fix issue configuring 0 values on UI
    [mqtt.cpp]
2022-06-20 fix invalid array index in HUB75
    [hub75.cpp]
2022-07-01 update led/neopixel brightness immediately
2022-07-13 Support client certificate authentication for MQTT
    Allow the MQTT connection to be authenticated via a client certificate
    read from the filesystem.
    This also fixes a bug/confusion where a "server" certificate was being
    passed in to the client certificate method - there is no server cert
    required, only the CA cert.
    [config.h, mqtt.cpp]
2022-07-16 feed ambient pressure BME680 -> Co2 sensors
2022-07-22 improved button press detection
2022-07-22 Sensor type clarification
2022-07-30 use single pwm channel for LEDs
2022-07-30 Fixed I2C::takeMutex
2022-07-31 single sensor loop task
2022-07-31 fix LEDs startup sequence
    [trafficLight.cpp]
2022-08-07 manual calibration, no auto AP
    - no longer launches AP when unable to connect to Wifi
    - manual calibration option via button
    [configManager.cpp, configManager.h, main.cpp]
2022-08-07 Faster I2C CLK
2022-08-09 fix 32 row display formatting
    [lcd.cpp, lcd.h]
2022-08-16 Longer calibration message on OLED
2022-09-21 Use updated esp32FOTA with LittleFS support
2022-09-21 fix esp32fota missing include error
2023-02-08 pin BSEC lib version
2023-03-16 ESP32-S3 additions
2023-03-16 log thread core in housekeeping
2023-03-18 Fix mqtt connection and WDT
    [main.cpp, mqtt.cpp]
2023-03-22 minor fix oled detection
    [main.cpp]
2023-04-15 close file on error
    [configManager.cpp]
2023-05-30 Support turning off lights below a threshold (#17)
    Some users want to only display lights when action is required to
    minimise distraction and visual pollution when all is well (e.g. in a
    bedroom at night, or an office).
    Address this request by adding a lower threshold (green), below which
    the lights are turned off rather than green being shown anytime the
    level is below the yellow threshold.
    Also contains a minor alignment to the CO2 levels to be <= the
    thresholds, rather than < to align with the iaq logic.
    Arduino JSON size estimator reports the two new values do not increase
    size above the current 1280 buffer value.
2023-05-31 Sensor loop timing fix
    [sensors.cpp]
2023-05-31 ESP32-S3 support (#19)
    [partitions-esp32-s3.csv, partitions-esp32.csv]
2023-05-31 Support building/tagging variants on branches (#18)
    To allow tagging the same version on different branches, we allow
    version tags to be suffixed with '-name' (for differentiation in git),
    and then strip the suffix following '-' in the versioning logic. This
    allows multiple branches to generate the 'same' version in different
    variants.
    When detecting which branch we're building from we need to look for the
    origin branch containing the tag, rather than the current method as git
    builds in a detached HEAD state, and to make this possible we need to
    set fetch-depth=0 on the checkout.
    Finally, to tie it all together we include the branch name in the
    generated version if the tag was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
2023-06-01 add esp32-s3 to workflow build (#20)
2023-06-01 Feature/multi platform workflow (#21)
    * add esp32-s3 to workflow build
    * echo GITHUB_TAG in workflow
2023-06-02 Always use short hash
    [git-rev.py]
2023-06-07 Check against invalid LED_PIN
2023-06-07 ESP32-S3 esptool fix
2023-07-05 Feature/wifi manager (#23)
    * WifiManager, Improv, Logger
    * Improv serial
    * Improv app version
    * Bump HUB75 lib to 3.0.8
    * Fix checkbox html
    * integrate configParameters in configManager
    * Use configParameters for MQTT
    * Fix logging on ESP32-S3
    * Enum configParameters
    * Extract template class definition
    * Authenticate UI, config change without restart
    * Remove dependency on model
    * publish sensors using JSONDocument
    * bugfix
    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
    [config.h, configManager.cpp, configManager.h, configParameter.cpp, configParameter.h, globals.h, housekeeping.cpp]
